phamtaiece/Capstone-Sightline/Weekly Reports/Week_20.docx

WEEKLY PROGRESS REPORT

Sightline Capstone Project

Week 20

27 May 2019

Tai:

This week:

- Work on the flight test with Kimball
- Work on the Poster with Kimball
- Work on the final report document

Next week:

- Meeting with Jeremy and do another fight test on Wednesday
- Finalize the poster design
- Work on the final report

Question:

None at this time

Kimball:

This Week:

- Attempted flight test with SLA1500OEM, had issues recording video to internal SD card
- There was a manufacturing delay of the SLA1500CAM due to a misaligned solder mask issue. The error was fixed new gerbers were compiled and sent to the manufacturer. With the holiday weekend we haven’t had any updates from the manufacturer.
- Finalized poster design with Tai pushed to Github (https://github.com/phamtaiece/Capstone-Sightline/blob/master/Final%20Documentation/Poster/Poster2.pdf)

Next Week:

- Flight Test scheduled for Wednesday to test quad-copter with SightLine hardware
- SLA1500CAM Testing if it arrives
- Upload poster design for printing
- Continue working on Design Report

Comments/Questions:

None at this time
