phamtaiece/Capstone-Sightline/Weekly Reports/Week_19.docx

WEEKLY PROGRESS REPORT

Sightline Capstone Project

Week 19

20 May 2019

Tai:

This week:

- Meeting with sponsor and advisor.
- Working on Poster and final report contents.
- Create a fight test video for demo.

Next week:

- Work on another flight test this week
- Work on poster and final report
- Do the test for the SLA-1500-CAM board if possible.

Question:

None at this time

Kimball:

This Week:

- Created and added the following content to the poster:
  - Premise section with three Infographics describing the project
  - Quadcopter description with two quadcopter images
  - Hardware description with images of top and bottom layers of SLA1500CAM

There is a pdf of the current poster on Github (https://github.com/phamtaiece/Capstone-Sightline/blob/master/Final%20Documentation/Poster/Poster1.pdf) Any feedback on the content that is currently there would be greatly appreciated

Next Week:

- Flight Test scheduled
- SLA1500CAM boards are expected to arrive on Friday
- SLA1500CAM Testing
- Finalize Poster content
- Send final poster content to graphic designer
- Continue working on Design Report

Comments/Questions:

None at this time
