phamtaiece/Capstone-Sightline/General Documents/1500CAMPROTOTYPE_FlightChecklist.docx

# CAPSTONE FLIGHT TEST

# GOAL:

Perform a flight test carrying the 1500-CAM prototype.

- Fly with additional weight
- Additional electrical load
- Use 1500-OEM to record flight video for post processing

# PREFLIGHT CHECKLIST

1. Verify Ethernet communication
2. Verify video in main Panel+ window
3. Verify streaming statistics
4. Verify microSD card is active

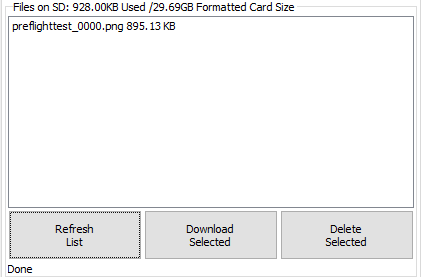
[picture p30: figure]

# FLIGHT PROCEDURE

1. Menu → Configure → KLV Setup…
  a. Simulate Data
  b. Display Decoded Value == MISB User Set
  c. VERIFY: UTC TIME == Current Date and Time
  d. Stop Simulation
  e. Tag Data Rate
    i. Check ID 2 box
    ii. Set Frame Step = 1
    iii. Send
  f. Close KLV Dialog
2. Verify KLV rate statistics
3. Record Tab: Single Frames (Snapshots)
  a. Set Filename (text only; no numbers)
  b. Start

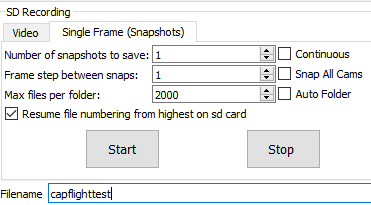
[picture p31: figure]

  c. Refresh List
  d. VERIFY: new file
4. Record Tab: Video
  a. Start
  b. Refresh List
  c. VERIFY: new file is getting created

# 1500-SETUP

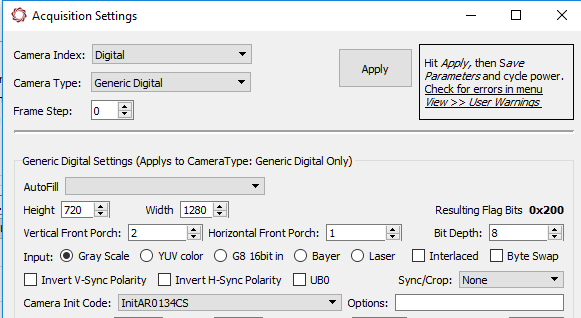
[picture p32: figure]
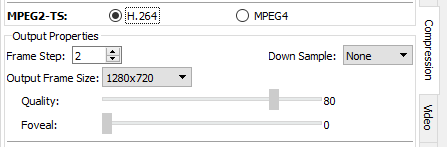
[picture p33: figure]
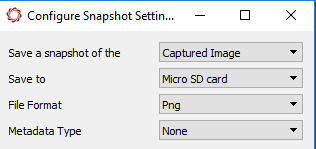
[picture p34: figure]
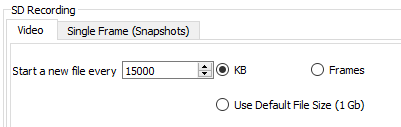
[picture p35: figure]
