phamtaiece/Capstone-Sightline/Final Documentation/PowerPoint/UAVLandingAid.pptx

UAV Visual Landing Aid

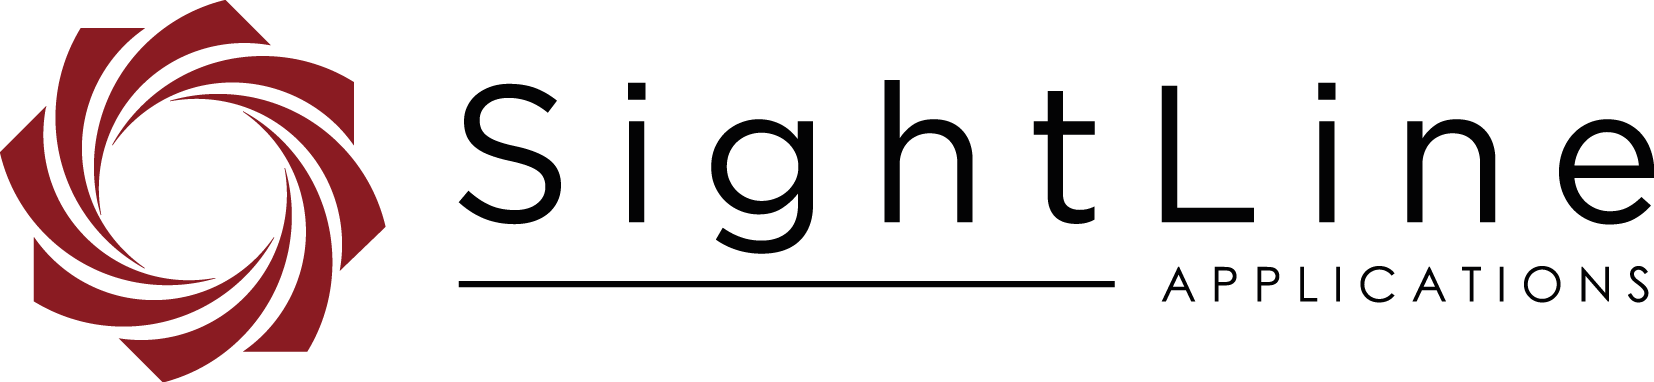
[picture p64: figure]

Tai Pham
Kimball Davis

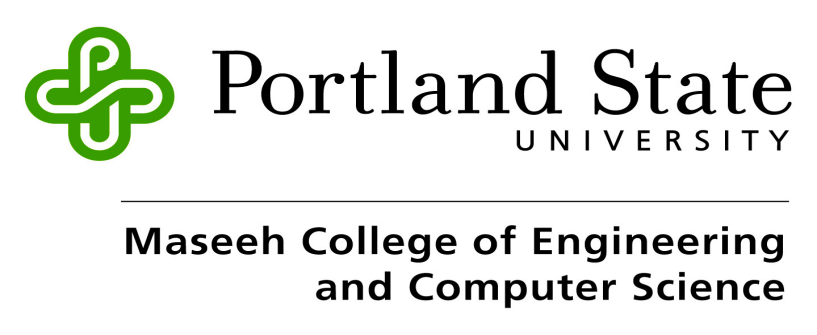
[picture p65: figure]

## Slide 2

SightLine Applications has developed a precision visual landing aid for UAV's. The Landing Aid supports autonomous landing operations by automatically finding and tracking an easy to place landing pattern.

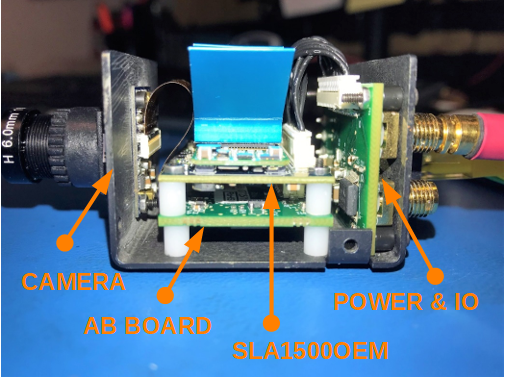
[picture p66: figure]
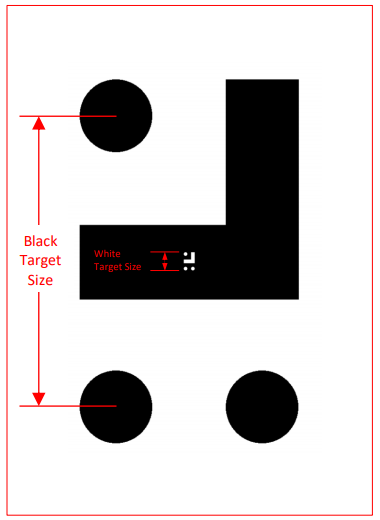
[picture p67: figure]

## Slide 3

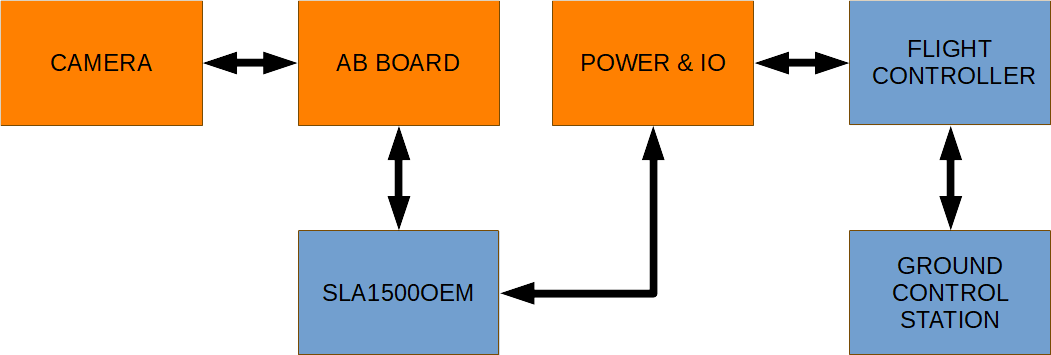
[picture p68: figure]

## Slide 4

## Slide 5

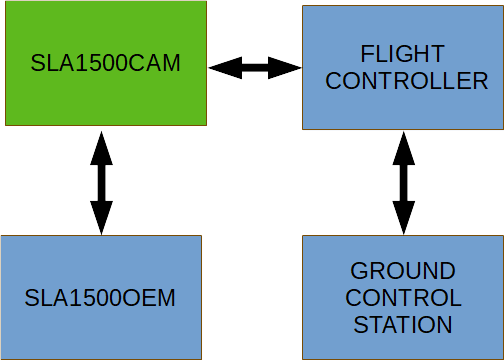
[picture p69: figure]
