phamtaiece/Capstone-Sightline/Final Documentation/Design Report/2019_ECECapstone_Team21.pdf

### PORTLAND STATE UNIVERSITY

DEPARTMENT OF ELECTRICAL AND COMPUTER ENGINEERING


## 2019 ECE CAPSTONE TEAM 21

FACULTY ADVISOR: ROY KRAVITZ, M.S.

SPONSOR: JEREMY SARAO, SIGHTLINE APPLICATIONS

# UAV Landing Aid - Design Report

### Authors:

KIMBALL S. DAVIS

TAI PHAM

June 5, 2019

### Abstract

Integration of the SightLine Landing Aid for end users is problematic. Often drone operators want to just “plug in” a component and fly their mission. Installing software components is acceptable, but any requirement for programming is a barrier to entry or a complete show stopper. Various cables, power, and other electrical connectivity issues are also difficult for vehicle integrator. Rugged or at least robust mechanical enclosures, easy mounting, and environmental reliability are equally important. Lastly, choice of optical system (camera) for the greatest range has cause adoption delays in that it has been a decision left to the integrator. Recognizing the needs from the end-users, SightLine wants to develop a plug and play precision landing aid for UAVs and expect that this new project will be highly valuable to a wide range of multi-copter integrator.
Our solution to the problem involves: I. Selecting, and building a consumer level quad-copter that will be easily customizable for testing II. Designing a camera that will connect directly to the SightLine hardware, distribute power, and facilitate communication III. Research and development of documentation and software to meet plug and play expectations.
The selection, build, and testing of a custom quad-copter is a complicated task with many variables. GPS signal degradation made indoor flight tests impossible, and safe outdoor testing locations were hard to find. We did successfully build, and autonomously fly the Pixhawk4 controlled quad-copter using QGroundControl mission planning software. In the meantime, a camera for the SightLine hardware was designed utilizing an AR0134CS optical sensor. The camera board was also designed to provide power distribution, and facilitate communication between the Pixhawk 4 flight controller and the Sight-Line hardware.
*Insert SLA1500CAM Test Results summary Here*
Based on our project, the QGroundControl has demonstrated a great ability to control our quad-copter autonomously. The QGroundControl provides the ability to fully control all quad-copter parameters and as well as setting up a mission. We have successfully flied the drone autonomously using QGroundControl includes takeoff, land, fly the mission, and return to land. The precision landing feature on QGround-Control is not very promising. For the simple function like takeoff and landing, the position between takeoff and land was about 1 meter. For the flying to a destination and return, the difference in position was 2 meter. Additionally, before doing the flight test, we also use Mission Planner to simulate the flight and learn how to control the quad-copter’s parameters.
*What are the limitations? The limitation comes from both QGroundControl and SightLine hardware. Since SightLine hardware, or 1500-SLA-kit, is unable to talk with QGroundControl and as well as, we don’t know if QGroundControl is capable of talking to SightLine hardware. There will be some works that SightLine need to be done with their hardware so it will be able to talk with QGroundControl. *What are the Future implications of the project?* The project is now divided into two parts. The first part is understand the Ground Control State software (QGroundControl) and hardware such as Pixhawk 4, and SLA1500CAM. The second part will emphasize in software and communication development. SightLine and our team has determined to leave the second part of the project for the future capstone team. With our achievements on this project, we have a strong belief that the future team will be successful in this project and future function development.

### Contents

1 Project Overview | 4
2 Results(Technical Detail) | 5
3 Conclusion/What’s Left to do | 11
4 Appendix | 12
5 References | 13

### List of Figures

1 | Level 1 block diagram of SLA1500CAM REV 8.0 | | 6
2 | Connector summary for SLA1500CAM REV 8.0 | | 7
3 | Connector summary for J1 | | 8
4 | SLA 1500 CAM REV 8.0 Schematic | | 9
5 | SLA1500CAM BOM REV 8.0 | | 10
6 | This is a caption for a blank figure | | 11
7 | This is a caption for a blank figure | | 11

### 1 Project Overview

### 1.1 Background

SightLine Applications has developed a precision visual landing algorithm that provides an excellent set of benefits:

- Works in degraded and denied GPS environments – Safety and reliability
- Reduces operator training and landing phase complexity.
- Provides detection functions for landing zone safety - detect people, animals, or objects from entering the landing zone
- Provides a rich set of telemetry for flight controllers. 30 Hz data with range, XY offsets, relative azimuth, etc.
- Supports landing on moving platforms - ground vehicles, marine.
- Is not impacted by bright sun or low light conditions.
- Can be used with Thermal (IR) cameras as well as visible (EO) cameras
- Effective range of operation (distance to target) only limited by the size of the landing pattern used

### 1.2 Problem Definition

Integration of the SightLine Landing Aid for end users is problematic for two main reasons:

1. Connectivity issues with a wide range of cameras.
2. Communication issues with a wide range of flight controller hardware and software.

Currently the end user selects a camera to be used with the SightLine processing hardware. A wide range of cameras must be supported, and custom AB boards must be designed for each one to interface with the SightLine hardware. Each of these AB boards can have cable, power, and electrical connectivity issues that are problematic for the end user. There is also a wide range of flight controller hardware and software, each with a myriad of different communication protocols. Installing software components to facilitate this communication is fine for the end user, but if any programming needs to be done this is usually a complete show stopper.

### 1.3 Solution

The proposed solution to these problems is to develop an all in one unit (SightLine Hardware w/Camera) with plug and play capabilities that can be directly connected to a consumer level flight controller. By doing so camera connectivity and selection problems are eliminated, and communication and software deployment are made much easier for the end user. We will build an off the shelf quad-copter with autonomous flight capabilities to test communication between current SightLine hardware, and our newly designed camera interface.

### 1.4 Project Management

The project is divided into three sections:

1. Choosing and building an "off the shelf" quad-copter that uses a Pixhawk 4 flight controller that can be used for testing
2. Designing a camera based on the On-Semi AR0134CS optical sensor that connects directly to the SightLine hardware, distributes power, and facilitates communication between the flight controller and SightLine hardware
3. Research and development of documentation and software installers to meet plug and play expectations using QGroundControl flight control and mission planning software

*Insert Project Roles and Responsibilities here*

### 1.4.1 Project Timeline

*Insert Project Timeline here*

### 2 Results(Technical Detail)

### 2.1 Quadcopter

Lorem ipsum dolor sit amet, consectetuer adipiscing elit. Etiam lobortis facilisis sem. Nullam nec mi et neque pharetra sollicitudin. Praesent imperdiet mi nec ante. Donec ullamcorper, felis non sodales commodo, lectus velit ultrices augue, a dignissim nibh lectus placerat pede. Vivamus nunc nunc, molestie ut, ultricies vel, semper in, velit. Ut porttitor. Praesent in sapien. Lorem ipsum dolor sit amet, consectetuer adipiscing elit. Duis fringilla tristique neque. Sed interdum libero ut metus. Pellentesque placerat. Nam rutrum augue a leo. Morbi sed elit sit amet ante lobortis sollicitudin. Praesent blandit blandit mauris. Praesent lectus tellus, aliquet aliquam, luctus a, egestas a, turpis. Mauris lacinia lorem sit amet ipsum. Nunc quis urna dictum turpis accumsan semper.

### 2.2 Hardware

The 1x1.5” SLA1500CAM utilizes the On-Semi AR0134CS, a monochrome 1/3-inch 1.2 Mp CMOS digital sensor with a 74MHz output. It connects seamlessly with the SightLine SLA1500OEM image processing hardware via a 50-pin Hirose DF12 connector. With a 5V input the SLA1500CAM converts and distributes the 3.3V, 2.8V, and 1.8V required for operation.

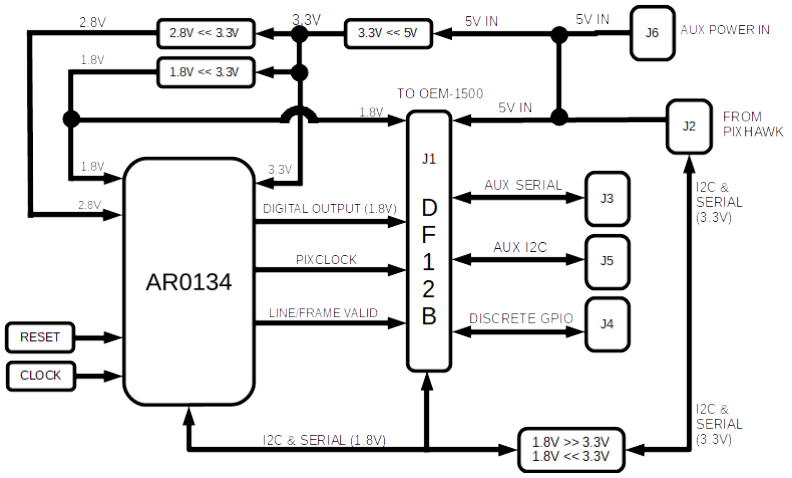
[picture p70: figure]

Figure 1: Level 1 block diagram of SLA1500CAM REV 8.0

The SLA1500CAM also provides bi-directional level translation for serial and I2C communication between the SightLine hardware, the flight controller, and the optical sensor. There are five I/O ports using standard Molex and JST connectors:

- Power and serial communication for the flight controller
- Auxiliary I2C bus
- Auxiliary serial communication
- Auxiliary power in

### 2.3 Connector Summary

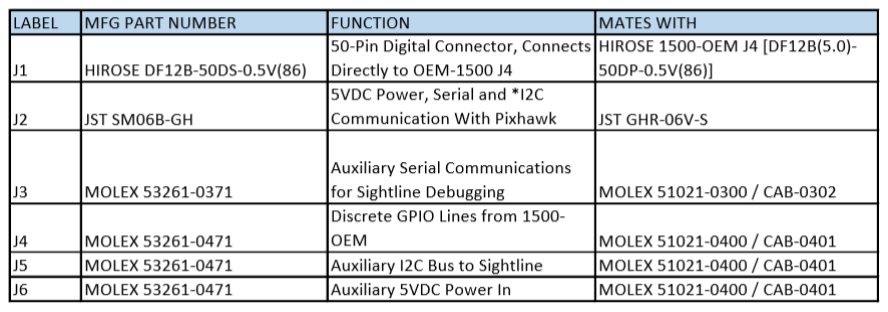
[picture p71: figure]

Figure 2: Connector summary for SLA1500CAM REV 8.0

### 2.3.1 Connector J1

Digital camera, serial, power for SLA1500OEM
This connector is designed to mate with the SLA1500OEM J4 connector.


Figure 3: Connector summary for J1

The GPIO connections for J1 are as follows:

- CAMGPIO 172 is connected to DNP Resistor R7 to AR0134 TRIGGER
- CAMGPIO 173 is connected to DNP Resistor R8 to AR0134 FLASH
- CAMGPIO 174 is connected to AR0134 RESET
- CAMGPIO 175 is connected to AR0134 STANDBY
- CAMGPIO 178 is connected to DNP resistor R26 to AR0134 OEBAR

AR0134 OEBAR is tied to ground with 0 OHM resistor R27.
*R27 MUST BE REMOVED BEFORE R26 IS INSTALLED AND CAMGPIO 178 CAN BE USED.


Figure 4: SLA 1500 CAM REV 8.0 Schematic

9

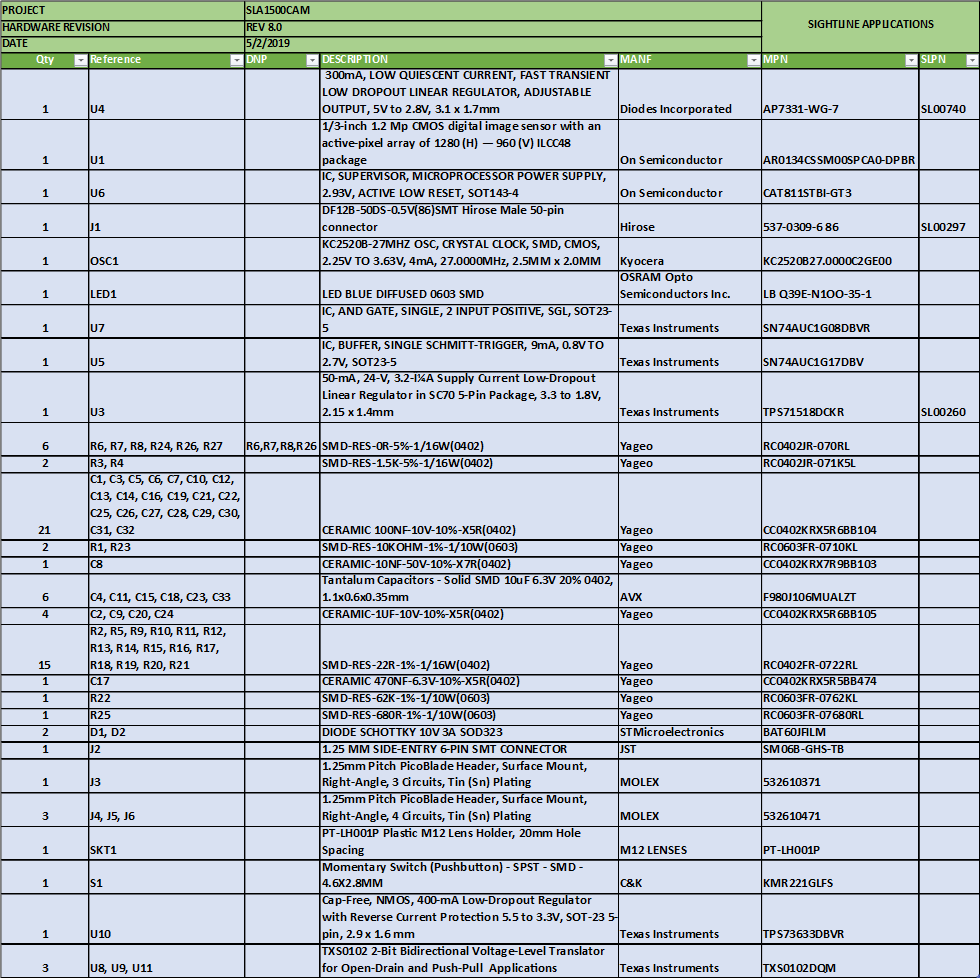
[picture p72: figure]

Figure 5: SLA1500CAM BOM REV 8.0

The schematic and PCB were designed using EAGLE CAD 9.2.1. Many of the component footprints and devices were unavailable and were designed specifically for the project. This involved designing the device, footprint, schematic symbol, and linking material data to each device. The entire EAGLE library for the SLA1500CAM can be found in the GitHub repository.
Eagle Library for SLA1500CAM (https://github.com/phamtaiece/Capstone-Sightline/tree/master/EAGLE%20files/Library)

### 2.4 Software

Lorem ipsum dolor sit amet, consectetuer adipiscing elit. Etiam lobortis facilisis sem. Nullam nec mi et neque pharetra sollicitudin. Praesent imperdiet mi nec ante. Donec ullamcorper, felis non sodales commodo, lectus velit ultrices augue, a dignissim nibh lectus placerat pede. Vivamus nunc nunc, molestie ut, ultricies vel, semper in, velit. Ut porttitor. Praesent in sapien. Lorem ipsum dolor sit amet, consectetuer adipiscing elit. Duis fringilla tristique neque. Sed interdum libero ut metus. Pellentesque placerat. Nam rutrum augue a leo. Morbi sed elit sit amet ante lobortis sollicitudin. Praesent blandit blandit mauris. Praesent lectus tellus, aliquet aliquam, luctus a, egestas a, turpis. Mauris lacinia lorem sit amet ipsum. Nunc quis urna dictum turpis accumsan semper.

Figure 6: This is a caption for a blank figure

### 3 Conclusion/What’s Left to do

Lorem ipsum dolor sit amet, consectetuer adipiscing elit. Etiam lobortis facilisis sem. Nullam nec mi et neque pharetra sollicitudin. Praesent imperdiet mi nec ante. Donec ullamcorper, felis non sodales commodo, lectus velit ultrices augue, a dignissim nibh lectus placerat pede. Vivamus nunc nunc, molestie ut, ultricies vel, semper in, velit. Ut porttitor. Praesent in sapien. Lorem ipsum dolor sit amet, consectetuer adipiscing elit. Duis fringilla tristique neque. Sed interdum libero ut metus. Pellentesque placerat. Nam rutrum augue a leo. Morbi sed elit sit amet ante lobortis sollicitudin. Praesent blandit blandit mauris. Praesent lectus tellus, aliquet aliquam, luctus a, egestas a, turpis. Mauris lacinia lorem sit amet ipsum. Nunc quis urna dictum turpis accumsan semper.

Figure 7: This is a caption for a blank figure

### 4 Appendix

### 4.1 I

### 4.2 II

### 4.3 II

### 4.4 IV

### 4.5 V

### 5 References

1. Mali, P. (1960). Magnetic Amplifiers. New York, NY: John F. Rider.
2. Figure 1. Simple saturable reactor. Reprinted from Magnetic Amplifiers(pg. 27), by Paul Mali, 1960, New York, NY, John F. Rider Publisher, Inc.
3. Figure 2. Full-wave self-saturating magnetic amplifier. Reprinted from Magnetic Amplifiers(pg. 35), by Paul Mali, 1960, New York, NY, John F. Rider Publisher, Inc.
