phamtaiece/Capstone-Sightline/Final Documentation/Design Report/CONN_J2-6.pdf

J2 | | | J3
PIN | DESCRIPTION | SIGNAL LEVEL | PIN | DESCRIPTION
1 | POWER IN | 5V | 1 | GND
2 | TXC | 3.3V | 2 | RXC
3 | RXC | 3.3V | 3 | TXC
4 NO CONNECT
5 NO CONNECT
6 GND
J4 | | | J5
PIN | DESCRIPTION | SIGNAL LEVEL | PIN | DESCRIPTION
1 | GND | | 1 | VSENSE
2 | CAMGPIO 172 | 1.8V | 2 | I2C SDA
3 | CAMGPIO 173 | 1.8V | 3 | I2C SCL
4 | CAMGPIO 178 | 1.8V | 4 | GND
J6
PIN | DESCRIPTION | SIGNAL LEVEL
1 | AUX POWER IN | 5V
2 | AUX POWER IN | 5V
3 GND
4 GND

SIGNAL LEVEL

3.3V
3.3V

SIGNAL LEVEL
3.3V
1.8V
1.8V
