phamtaiece/Capstone-Sightline/Final Documentation/Design Report/DF12B_J1_CONN.pdf

PIN | DESCRIPTION | SINGAL LEVEL | PIN | DESCRIPTION | SIGNAL LEVEL
1 | UART RX CAM | VIOSEL | 2 | UART TX CAM | VIOSEL
3 | LINE VALID | VIOSEL | 4 | FRAME VALID | VIOSEL
5 | DGND | | 6 | DGND
7 | 12C SDA | VIOSEL | 8 | I2C SCL | VIOSEL
9 | CAMGPIO 175 | VIOSEL | 10 | NO CONNECT
11 | NO CONNECT | | 12 | NO CONNECT
13 | CAMGPIO 174 | VIOSEL | 14 | CAMGPIO 173 | VIOSEL
15 | RXC | VIOSEL | 16 | TXC | VIOSEL
17 | DGND | | 18 | NO CONNECT
19 | CAMGPIO 178 | VIOSEL | 20 | NO CONNECT
21 | NO CONNECT | | 22 | NO CONNECT
23 | CAM D11 | VIOSEL | 24 | CAM D10 | VIOSEL
25 | CAM D9 | VIOSEL | 26 | CAM D8 | VIOSEL
27 | DGND | | 28 | DGND
29 | CAM D7 | VIOSEL | 30 | CAM D6 | VIOSEL
31 | CAM D5 | VIOSEL | 32 | CAM D4 | VIOSEL
33 | CAM D3 | VIOSEL | 34 | CAM D2 | VIOSEL
35 | CAM D1 | VIOSEL | 36 | CAM D0 | VIOSEL
37 | DGND | | 38 | DGND
39 | CAM PCLK | VIOSEL | 40 | CAMGPIO 172 | VIOSEL
41 | DGND | | 42 | AGND
43 | NO CONNECT | | 44 | AGND
45 | DGND | | 46 | VIOSEL | 1.8V
47 | DGND | | 48 | POWER IN | 5V
49 | DGND | | 50 | POWER IN | 5V
