phamtaiece/Capstone-Sightline/Final Documentation/Poster/2019ECECapstoneTeam21.pdf

# UAV Visual Landing Aid

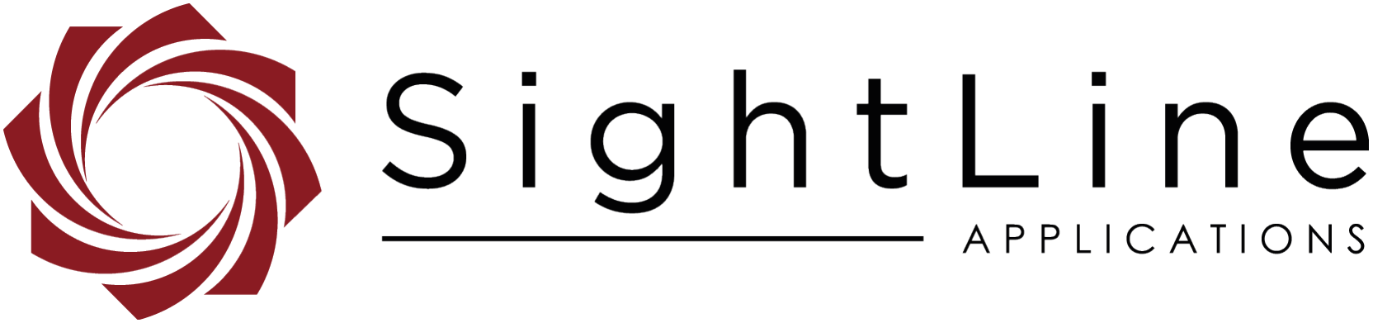
[picture p73: figure]

# Premise

SightLine Applications has developed a precision visual landing aid for UAV's. The Landing Aid supports autonomous landing operations by automatically finding and tracking an easy to place landing pattern.

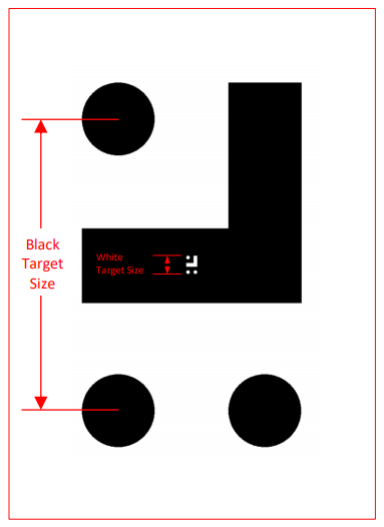
[picture p74: figure]
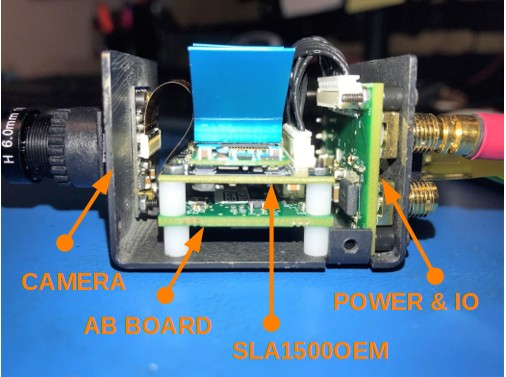
[picture p75: figure]
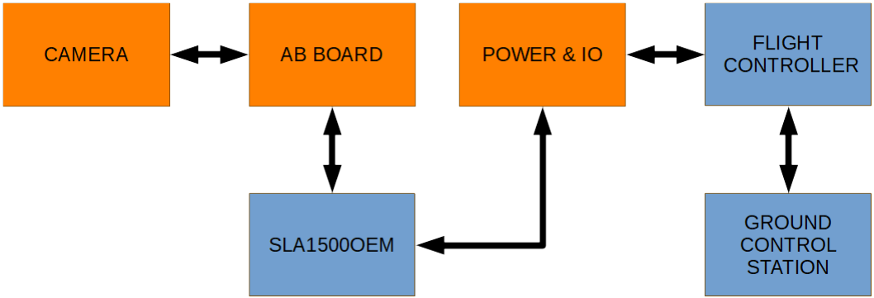
[picture p76: figure]

The multiple boards, complex wiring, and connections are problematic for the end user.

The proposed solution is to develop an all in one unit with plug and play capabilities that can be directly connected to the SightLine hardware.

By doing so camera connectivity and selection problems are eliminated, and deployment is made much easier for the end user.

# Solution

Mission Planner is an open source software that allows users and developers to fully control their drone. In this project, Mission Planner was used for setting up flight simulations.

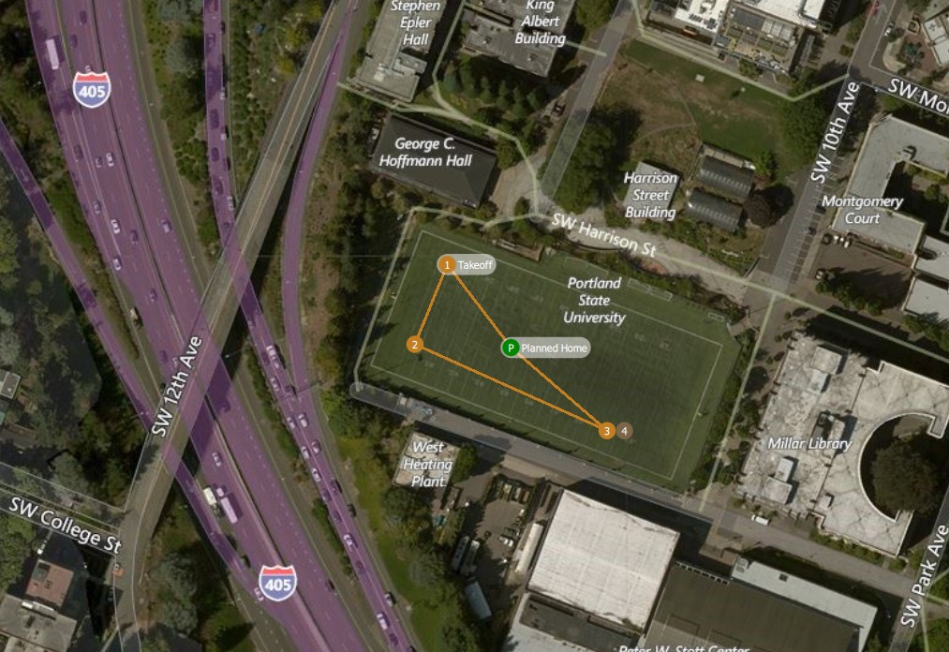
[picture p77: figure]
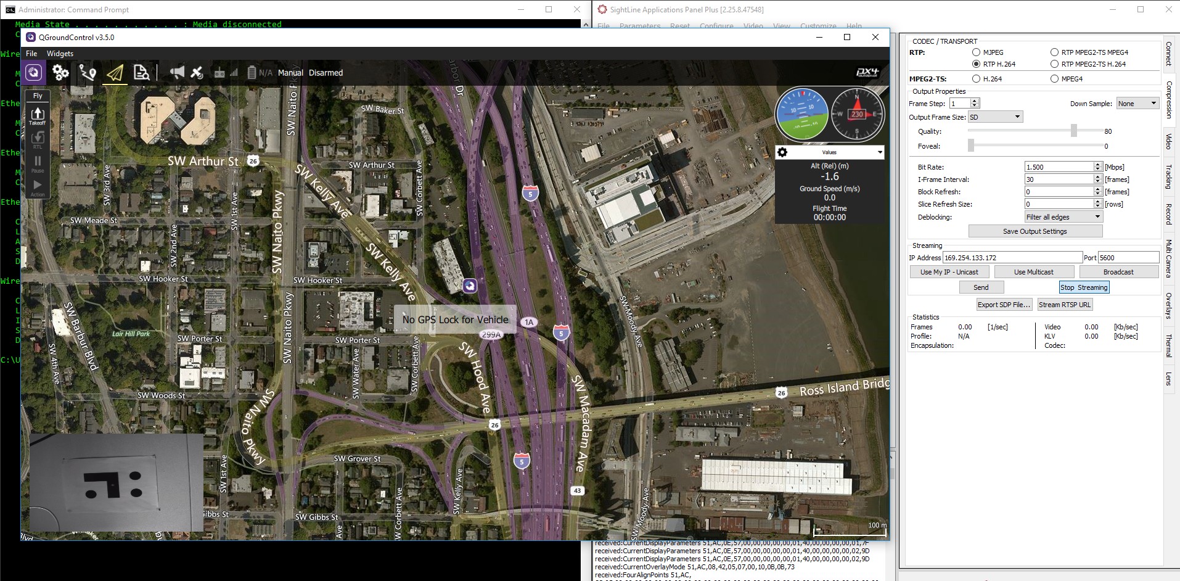
[picture p78: figure]

QGroundControl is an open-source software that allows users and developers to control their drone fully and autonomously. QGroundControl was used as the ground control station to send commands to the Pixhawk4 and control the quad-copter.

For testing purposes a custom quad-copter was built with a Pixhawk4 flight controller.

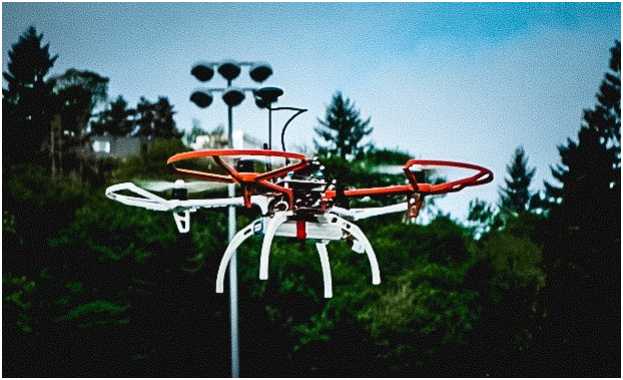
[picture p79: figure]
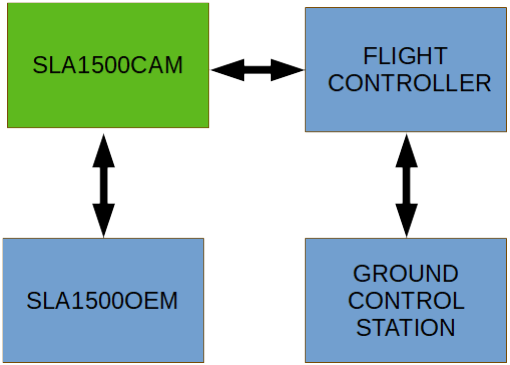
[picture p80: figure]
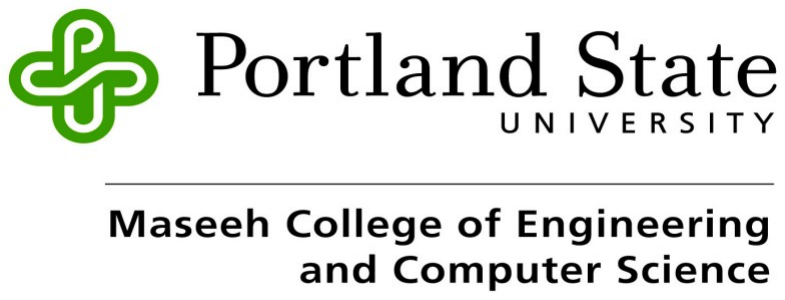
[picture p81: figure]

Using QGroundControl software the quad-copter was flown to different way points and landed autonomously via the ground control station. This was vital to understanding UAV operation, and end user experience.

## Software

## Hardware

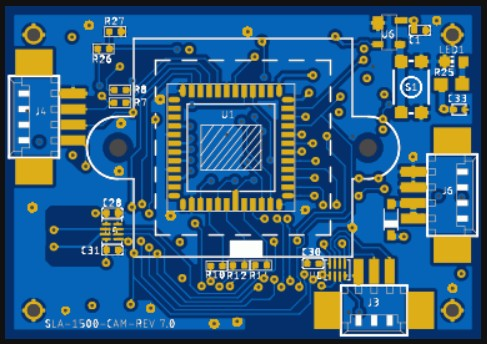
[picture p82: figure]
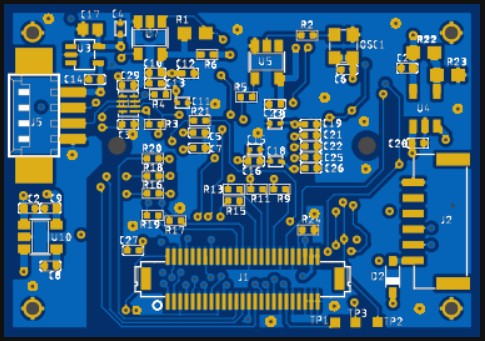
[picture p83: figure]

The 1”x1.5” SLA1500CAM utilizes the On-Semi AR0134CS a monochrome 1/3-inch 1.2 Mp CMOS digital sensor with a 74MHz output

- Connects seamlessly with the SightLine SLA1500OEM image processing hardware reducing cables and improving connectivity
- With 5V input converts and distributes the 3.3V, 2.8V, and 1.8V required for operation
- Provides level translation for communication between the SightLine hardware, the flight controller, and the optical sensor
- Offers additional power and communication I/O

# Results

- Successfully developed the SLA1500CAM
- Gained insight into communication between QGroundControl, Pixhawk4, and SightLine hardware
- Successfully completed autonomous flight and landing with custom quad-copter and QGroundControl

# Future Developments

- Compatibility issues remain with QGroundControl, SightLine hardware, and Pixhawk4
- Potentially, a new project will focus on software and communication for a future team that is interested in drone communication protocols
- With our achievements on this project we believe that full integration of the SLA1500CAM with plug and play capabilities can be achieved

This helped to understand the drone’s behavior and how adjusting the drone’s parameters could affect the behavior of the drone.
