phamtaiece/Capstone-Sightline/Quad_Copter/Capstone_Quadcopter_BOMPP.pdf

Project | Capstone Quadcopter | Sightline
Hardware Revision | V
Date | 01/31/19
Quantity | Description | Mfg | Weight (g) | Cost Per Item | Total Cost
1 | DJI FLAMEWHEEL F450 ARF KIT | DJI | 604.4 | $229.00 | $229.00
1 | DJI FLAMEWHEEL LANDING GEAR (4 pcs) | DJI | 60 | $17.50 | $17.50
1 | FrSky Taranis X9D Plus 16-Channel 2.4ghz ACCST Radio Transmitter | FrSky | N/A | $229.00 | $229.00
1 | FrSky X4RSB 3/16CH Telemetry Receiver Full Range | FrSky | 5.8 | $31.99 | $31.99
2 | Gens ace 14.8V 5000mAh 45C 4S LiPo Battery Pack | Gens Ace | 480 | $64.99 | $129.98
1 | PIXHAWK 4 ADVANCED DEVELOPMENT KIT | HOLYBRO | 200 | $210.95 | $210.95
1 | Discharger 1S-6S Digital Battery Pack Charger | Tenergy | N/A | $54.99 | $54.99
1 | PIXHAWK 4 RADIO TELEMETRY KIT | HOLYBRO | 15 | $39.95 | $39.95
1 | XT-60 CONNECTORS MALE/FEMALE | MakerDoIt | 12 | $11.99 | $11.99
1 | Prop Guards for DJI Flamewheel | Summit Link | 120 | $19.95 | $19.95
1 | RAYCorp 9450 Self-Tightening (9.4x5) Propellers. 8 Pieces(4CW, | RAYCORP | N/A | $13.99 | $13.99
| | ESTIMATED WEIGHT (g) | 1497.2 | Total Cost | $989.29
