phamtaiece/Capstone-Sightline/EAGLE files/Images/SLA1500_CAM_V7.pdf

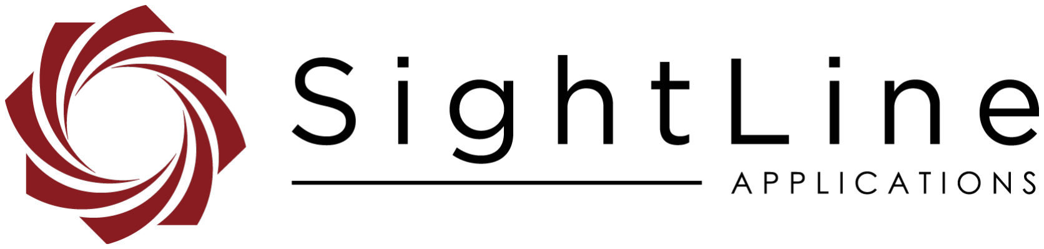
[picture p84: figure]

# SLA 1500 CAM REV 7.0

April 21, 2019

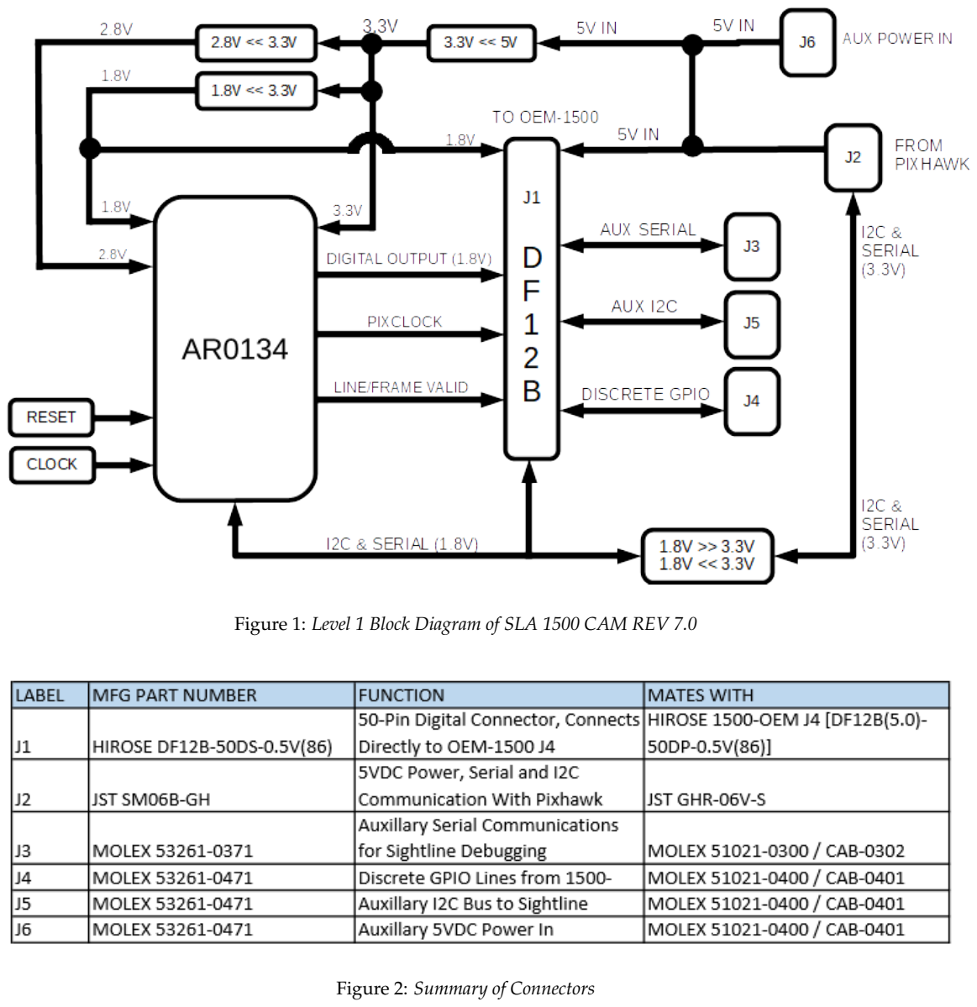
[picture p85: page 2]

Figure 1: Level 1 Block Diagram of SLA 1500 CAM REV 7.0

Figure 2: Summary of Connectors

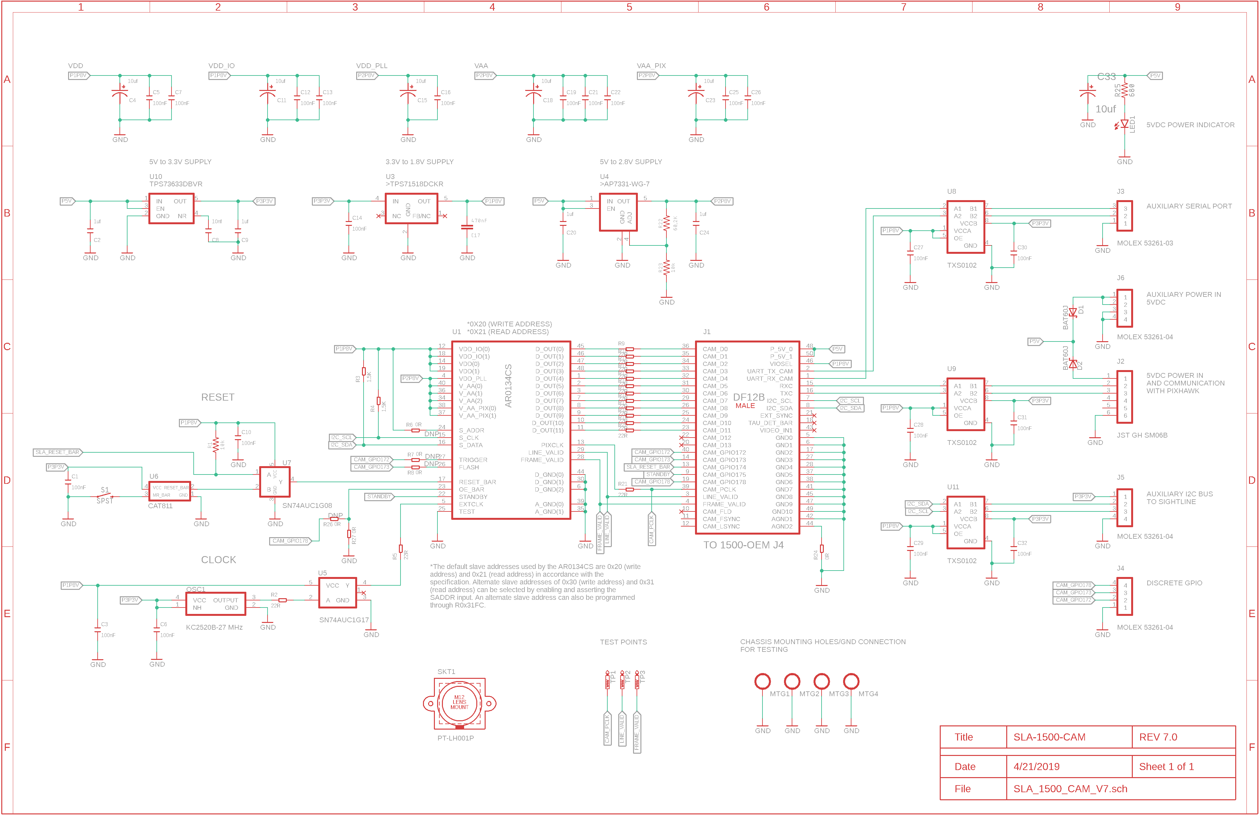
[picture p86: page 3]

Figure 3: SLA 1500 CAM REV 7.0 Schematic
