phamtaiece/Capstone-Sightline/EAGLE files/Images/SLA1500_CAM_V6.pdf

# SLA 1500 CAM REV 6.0

April 9, 2019

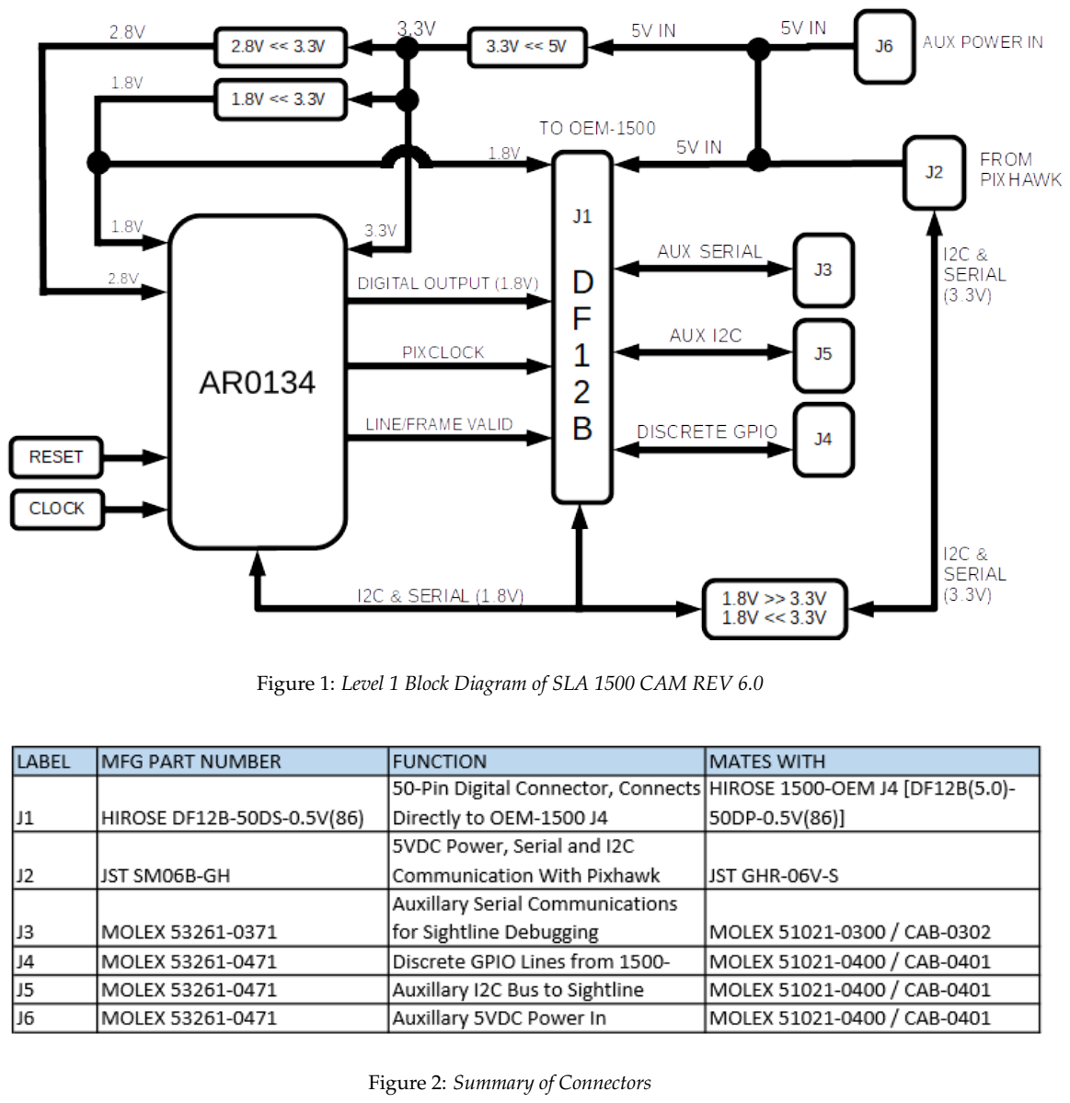
[picture p87: page 2]

Figure 1: Level 1 Block Diagram of SLA 1500 CAM REV 6.0

Figure 2: Summary of Connectors

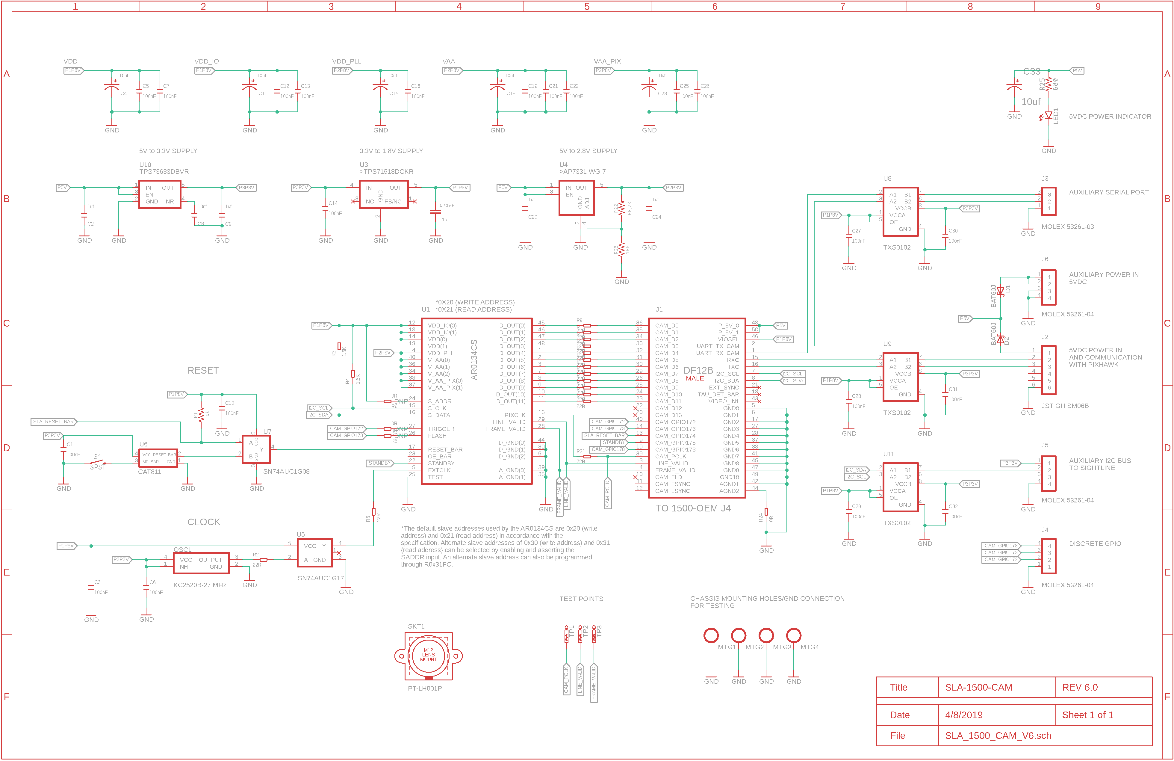
[picture p88: page 3]

Figure 3: SLA 1500 CAM REV 6.0 Schematic
