phamtaiece/Capstone-Sightline/EAGLE files/Images/SLA1500_CAM_V5.pdf

# SLA 1500 CAM REV 5.0

April 3, 2019

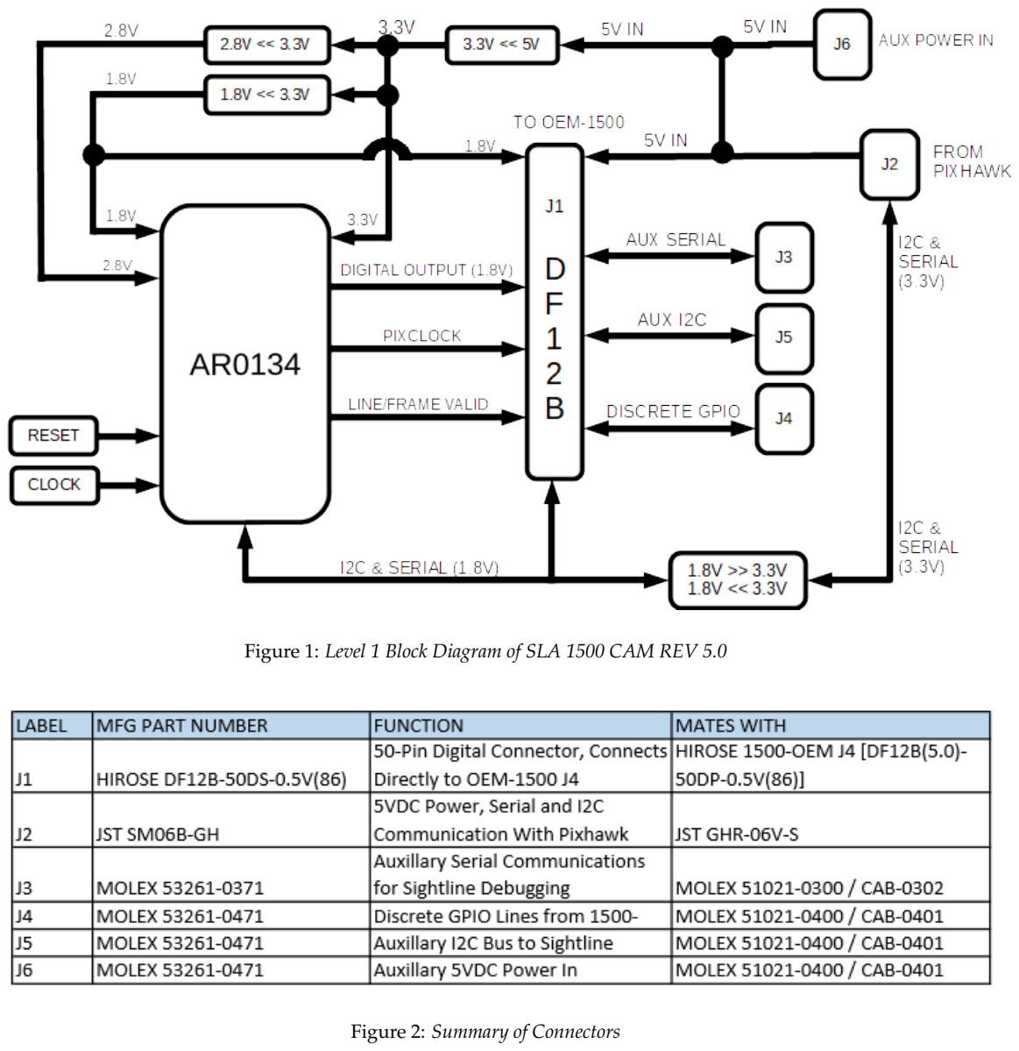
[picture p89: page 2]

Figure 1: Level 1 Block Diagram of SLA 1500 CAM REV 5.0

Figure 2: Summary of Connectors

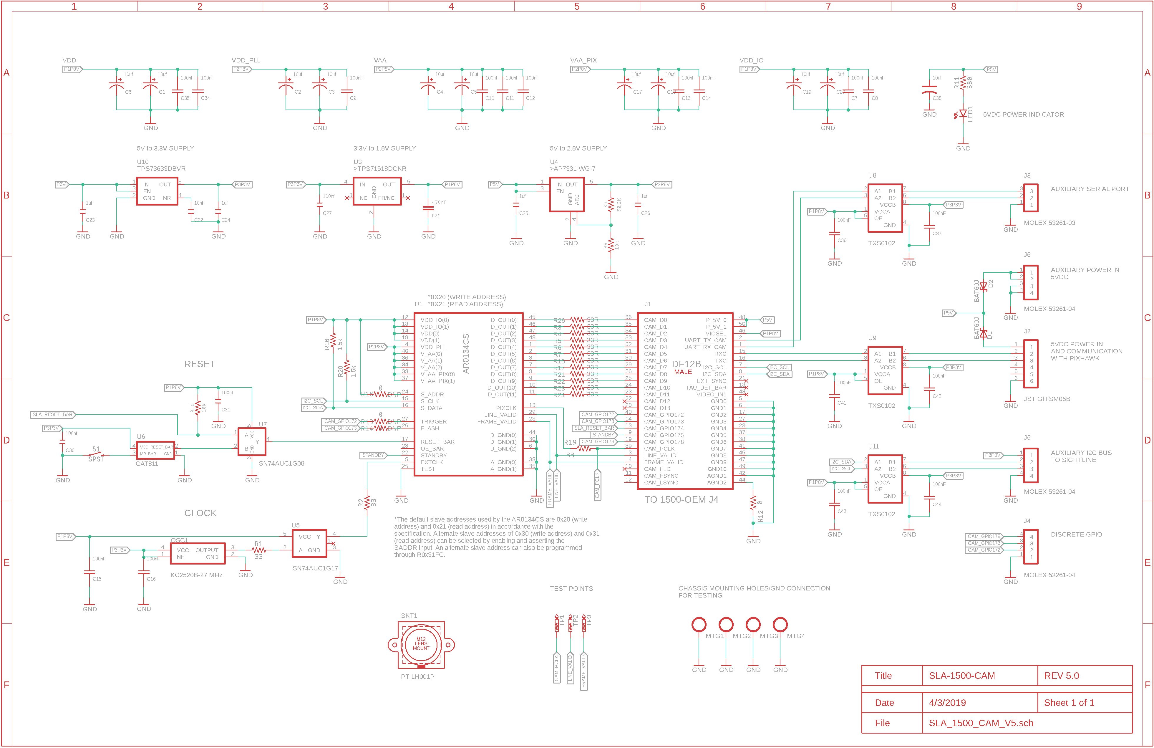
[picture p90: page 3]

Figure 3: SLA 1500 CAM REV 5.0 Schematic
