phamtaiece/Capstone-Sightline/EAGLE files/Images/SLA1500_CAM_V4.pdf

# SLA 1500 CAM REV 4.0

March 25, 2019

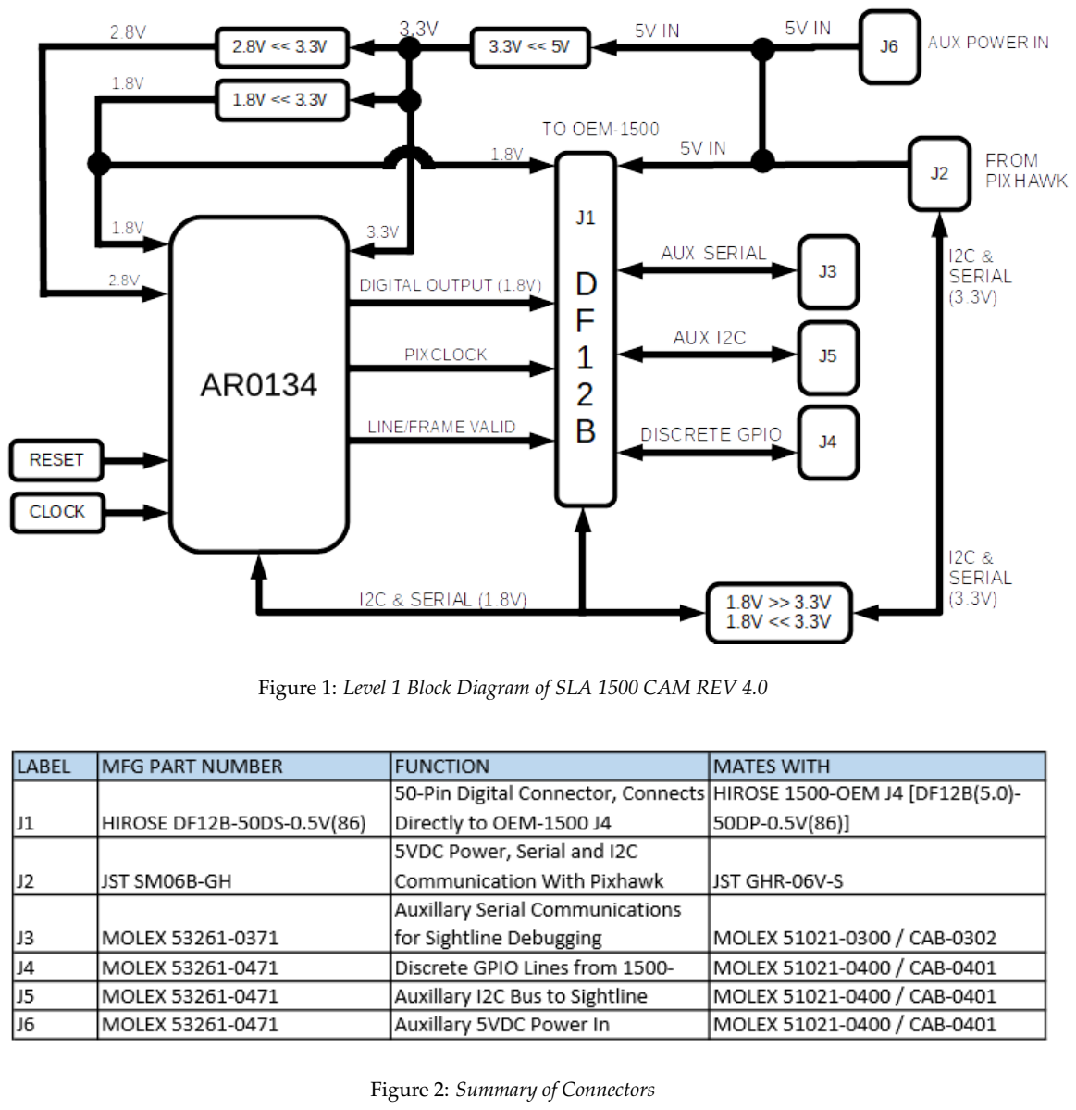
[picture p91: page 2]

Figure 1: Level 1 Block Diagram of SLA 1500 CAM REV 4.0

Figure 2: Summary of Connectors

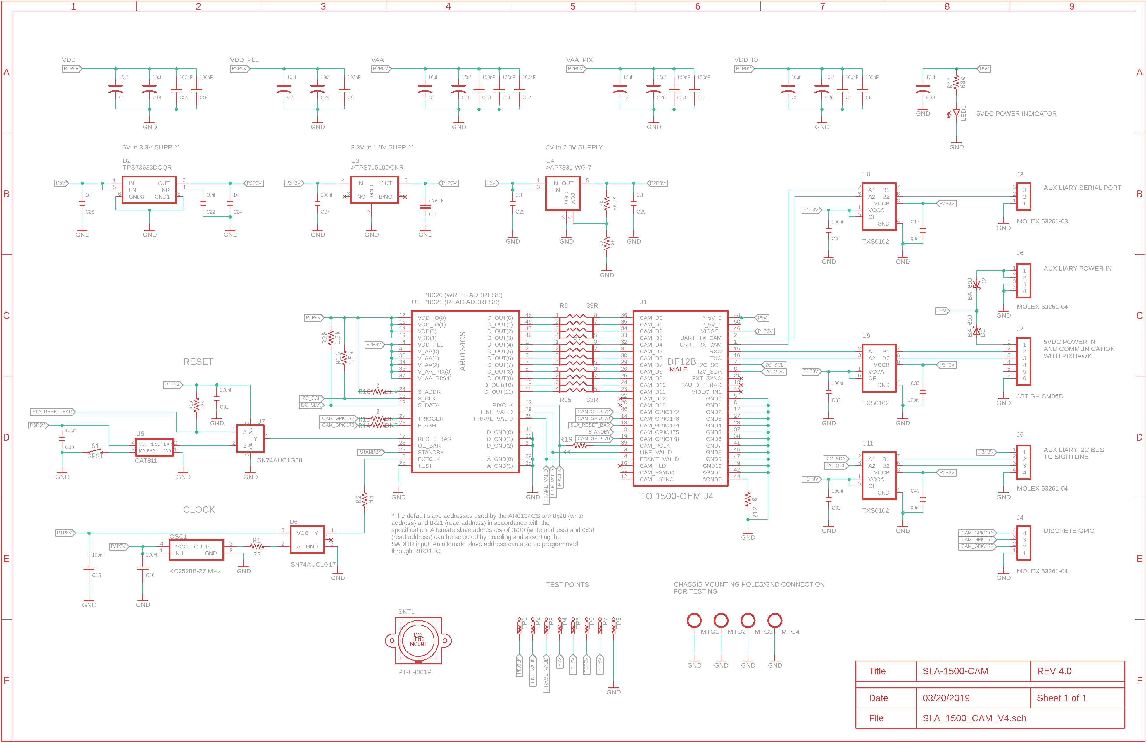
[picture p92: page 3]

Figure 3: SLA 1500 CAM REV 4.0 Schematic
