phamtaiece/Capstone-Sightline/EAGLE files/Images/SLA1500_CAM_V3.pdf

# SLA 1500 CAM REV 3.0

March 16, 2019

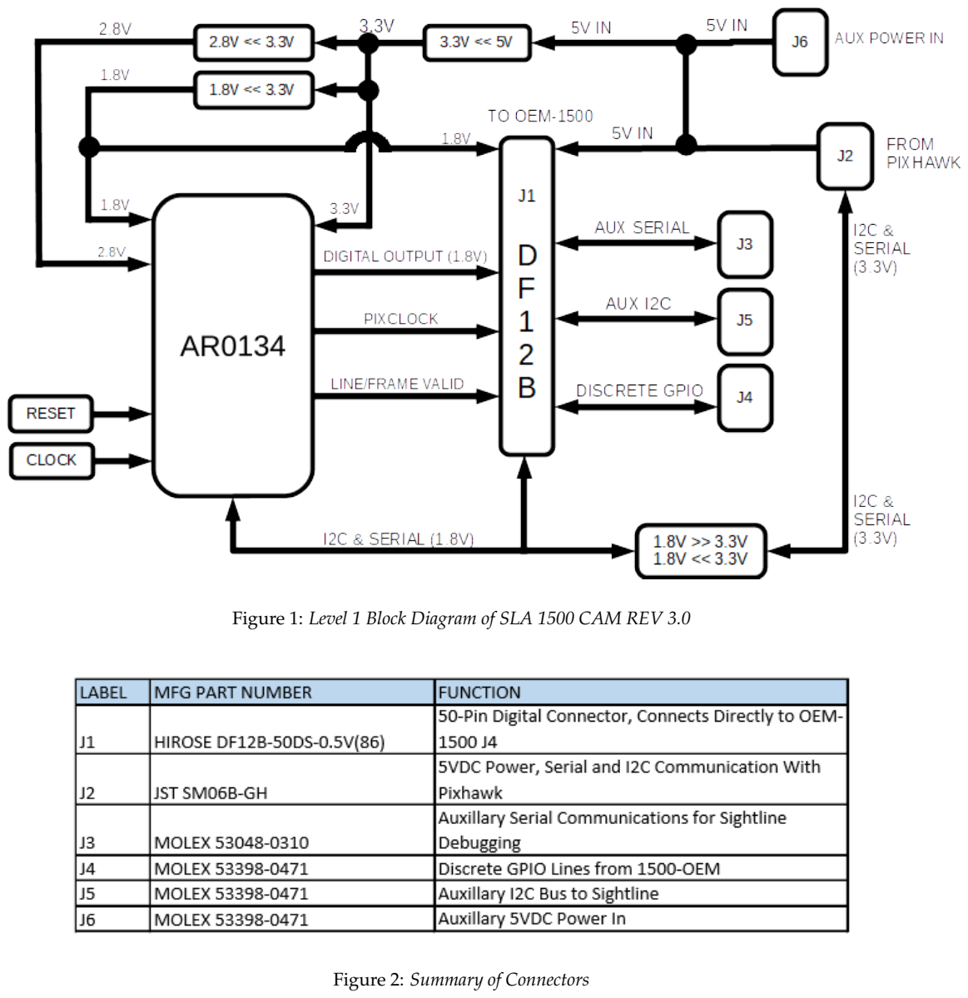
[picture p93: page 2]

Figure 1: Level 1 Block Diagram of SLA 1500 CAM REV 3.0

Figure 2: Summary of Connectors

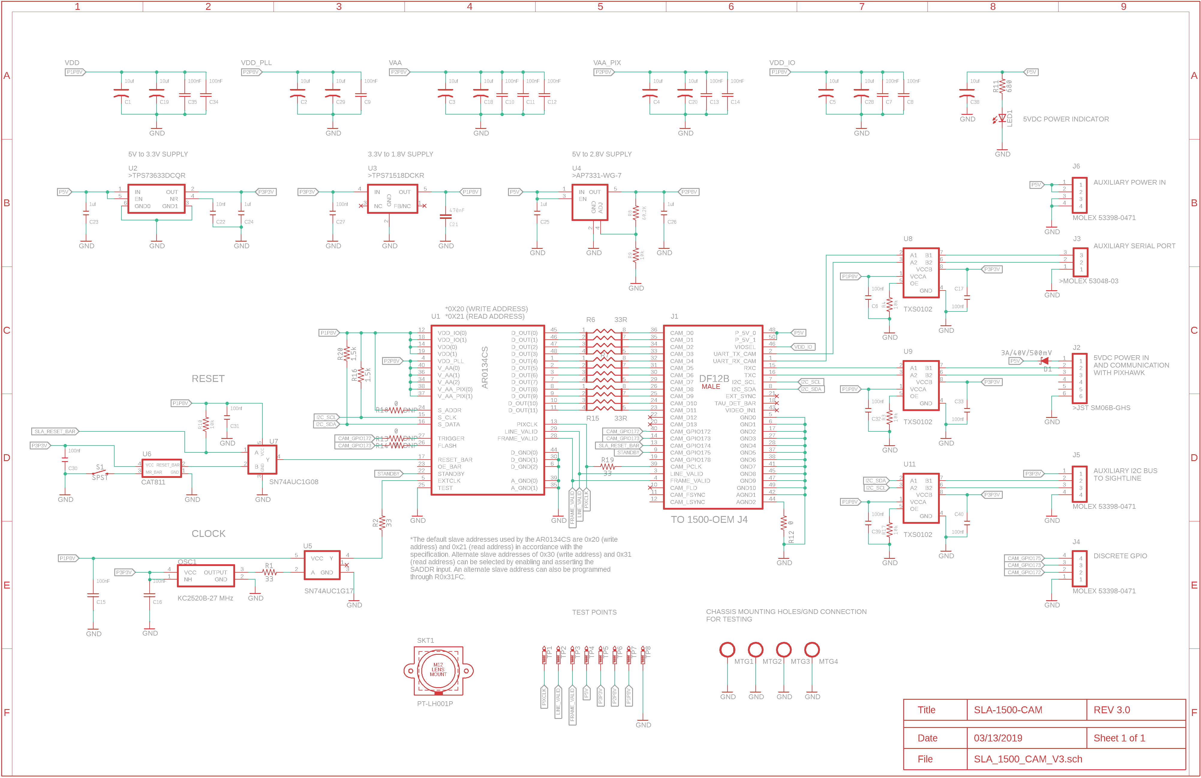
[picture p94: page 3]

Figure 3: SLA 1500 CAM REV 3.0 Schematic
