phamtaiece/Capstone-Sightline/EAGLE files/Images/SLA1500_CAM_V2.pdf

# SLA 1500 CAM REV 2.0

March 4, 2019

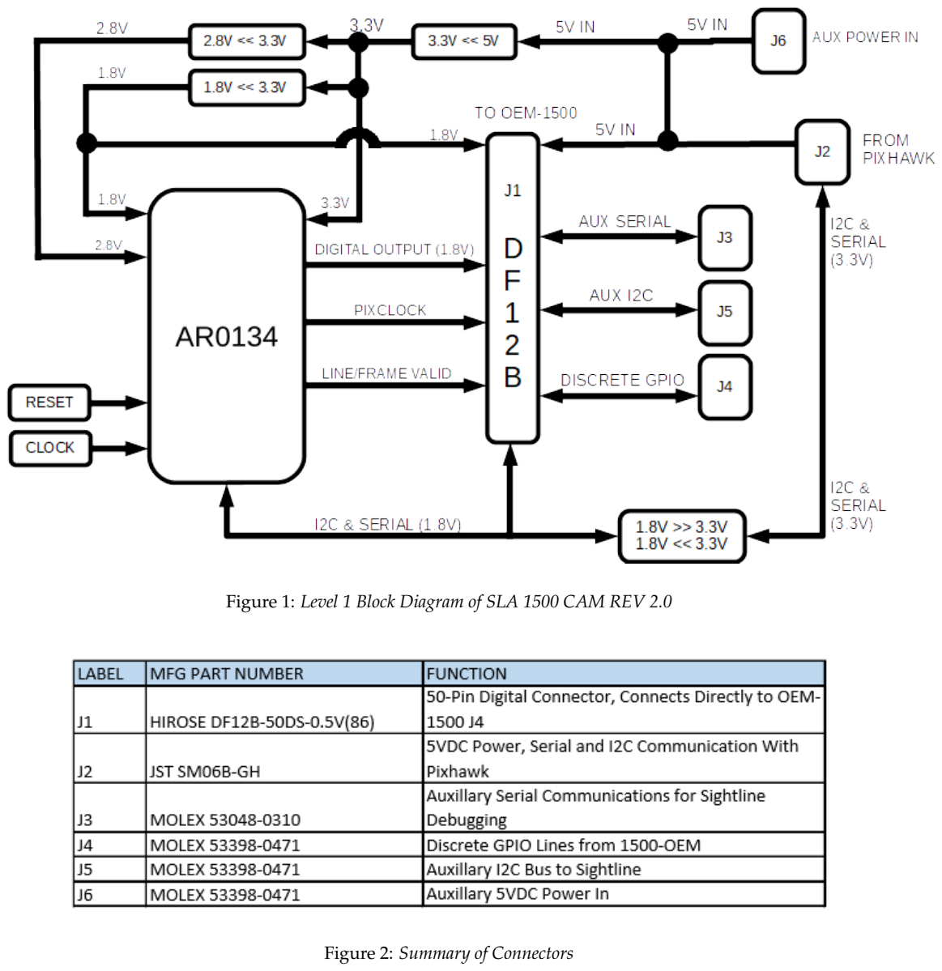
[picture p95: page 2]

Figure 1: Level 1 Block Diagram of SLA 1500 CAM REV 2.0

Figure 2: Summary of Connectors

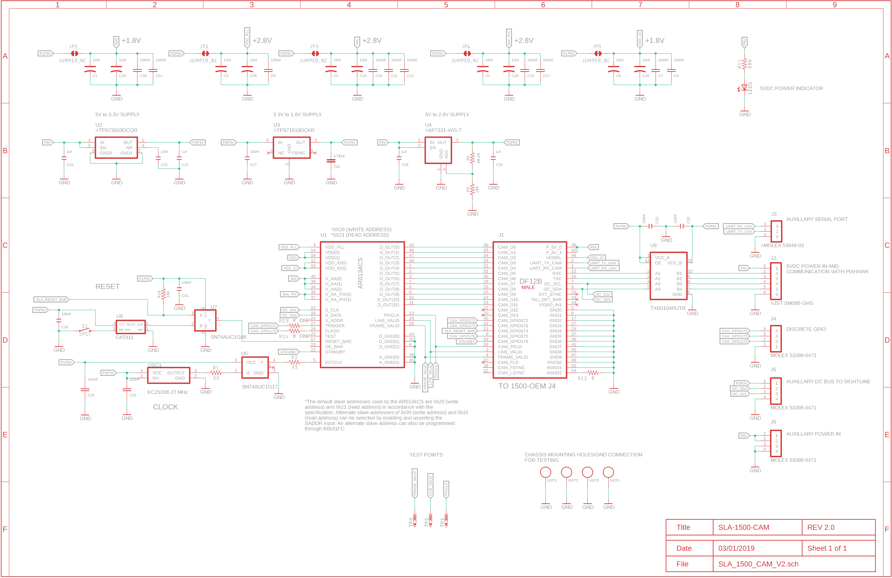
[picture p96: page 3]

Figure 3: SLA 1500 CAM REV 2.0 Schematic
