phamtaiece/Capstone-Sightline/EAGLE files/Images/SLA1500_CAM_V1.pdf

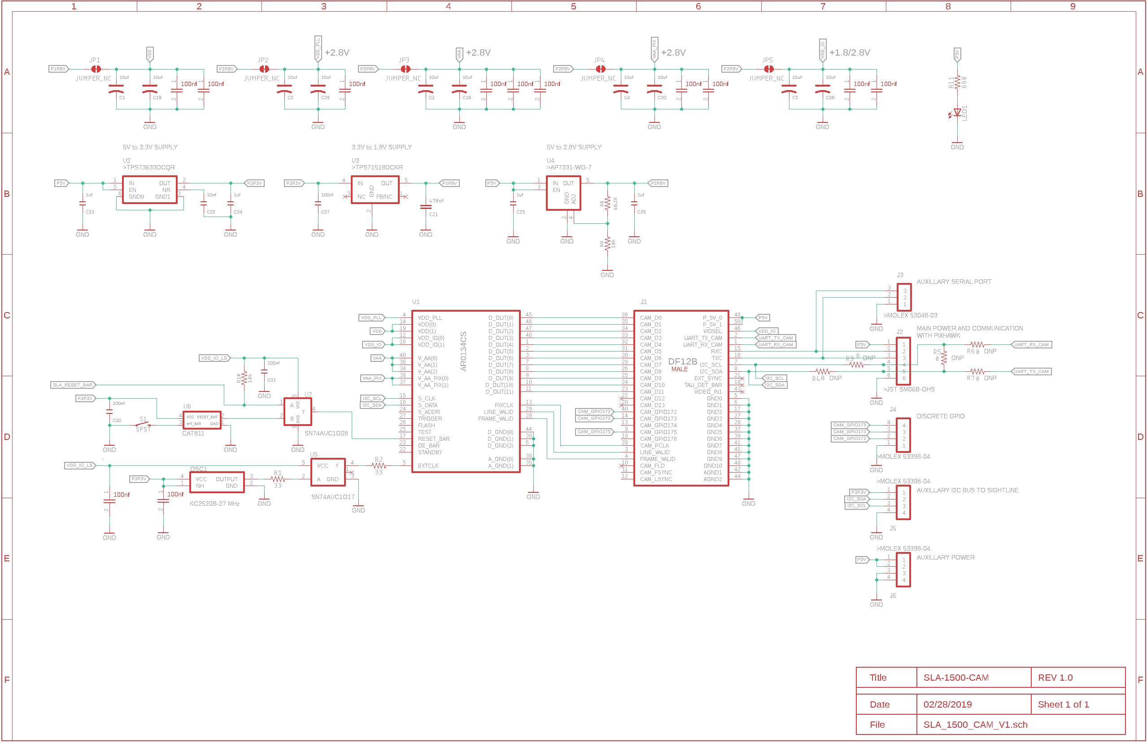
[picture p97: page 1]
