phamtaiece/Capstone-Sightline/Final Documentation/Design Report/quadcopter1.PNG

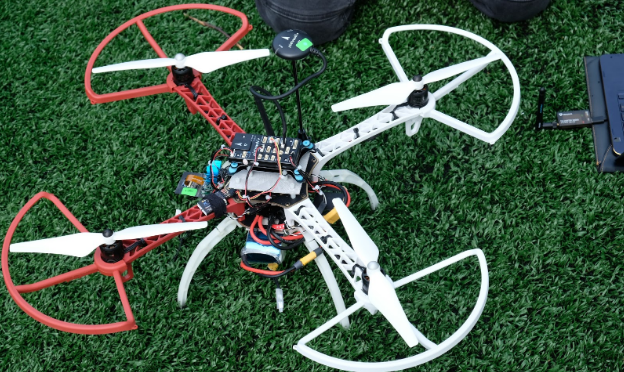
Final Documentation/Design Report/quadcopter1.PNG
