phamtaiece/Capstone-Sightline/Final Documentation/Design Report/QUADCOPTER2.png

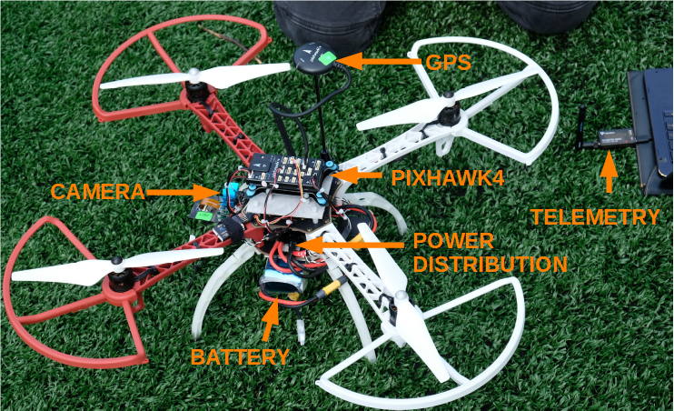
Final Documentation/Design Report/QUADCOPTER2.png
