phamtaiece/Capstone-Sightline/Final Documentation/JST.png

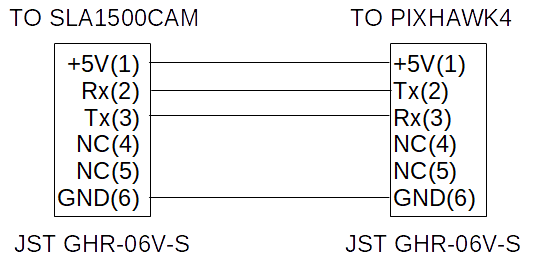
Final Documentation/JST.png
