phamtaiece/Capstone-Sightline/Final Documentation/Poster/quad1.jpg

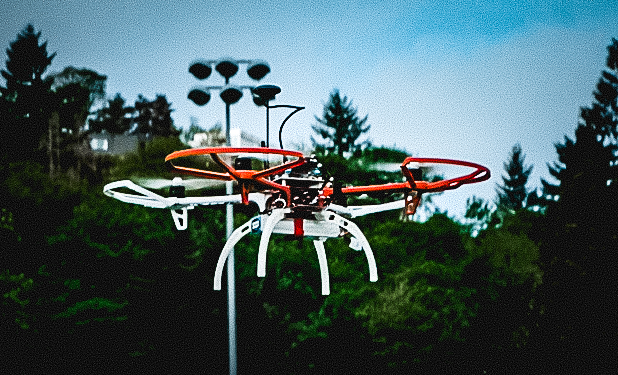
Final Documentation/Poster/quad1.jpg
