phamtaiece/Capstone-Sightline/Photos/20190213_102907.jpg

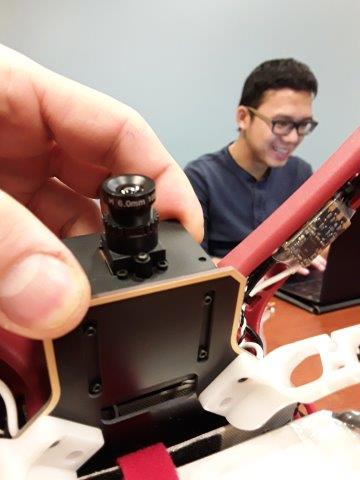
Photos/20190213_102907.jpg
