phamtaiece/Capstone-Sightline/Photos/20190213_102953.jpg

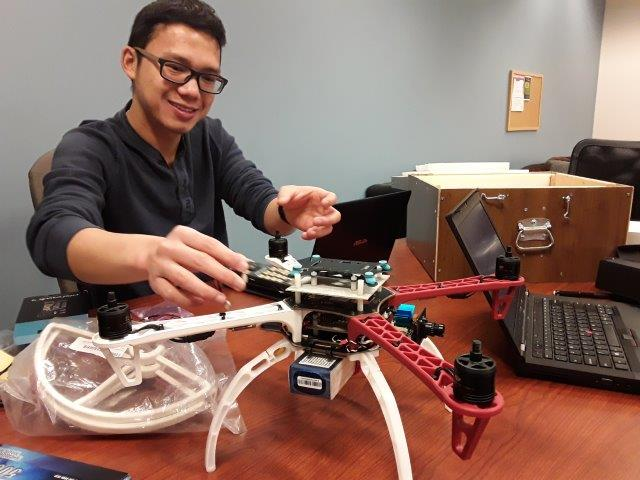
Photos/20190213_102953.jpg
