phamtaiece/Capstone-Sightline/Photos/20190213_113135.jpg

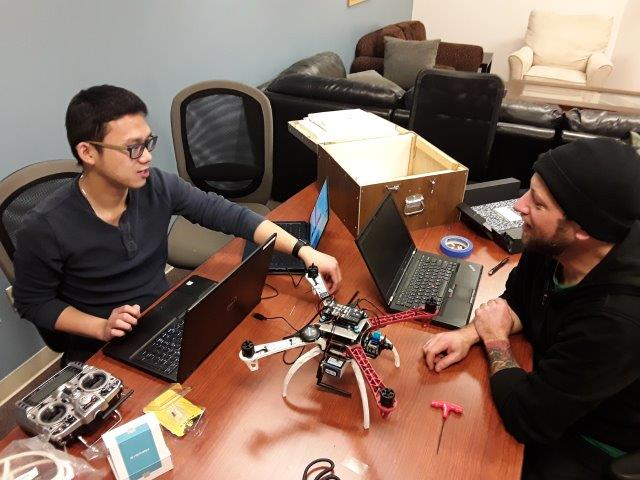
Photos/20190213_113135.jpg
