phamtaiece/Capstone-Sightline/Photos/20190214_130147.jpg

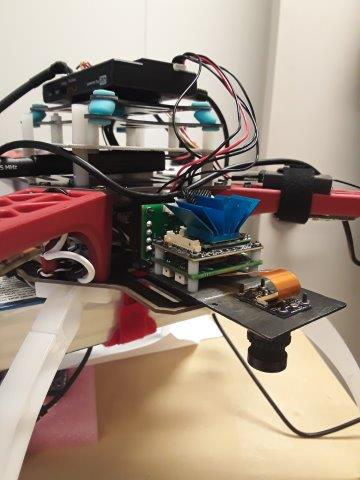
Photos/20190214_130147.jpg
