phamtaiece/Capstone-Sightline/Quad_Copter/DJI 450 datasheets/f450bottom_dim.png

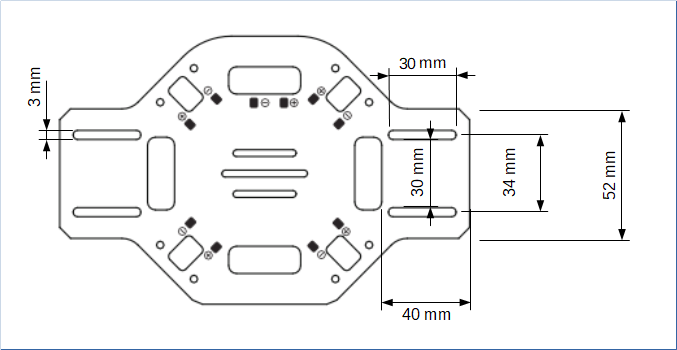
Quad_Copter/DJI 450 datasheets/f450bottom_dim.png
