phamtaiece/Capstone-Sightline/EAGLE files/SLA_1500_CAM_BOM_V8.xlsx

PROJECT |  | SLA1500CAM |  |  | SIGHTLINE APPLICATIONS
HARDWARE REVISION |  | REV 8.0
DATE |  | 2019-05-02
Qty | Reference | DNP | DESCRIPTION | MANF | MPN | SLPN
1 | U4 |  | 300mA, LOW QUIESCENT CURRENT, FAST TRANSIENT LOW DROPOUT LINEAR REGULATOR, ADJUSTABLE OUTPUT, 5V to 2.8V, 3.1 x 1.7mm | Diodes Incorporated | AP7331-WG-7 | SL00740
1 | U1 |  | 1/3-inch 1.2 Mp CMOS digital image sensor with an active-pixel array of 1280 (H) — 960 (V) ILCC48 package | On Semiconductor | AR0134CSSM00SPCA0-DPBR
1 | U6 |  | IC, SUPERVISOR, MICROPROCESSOR POWER SUPPLY, 2.93V, ACTIVE LOW RESET, SOT143-4 | On Semiconductor | CAT811STBI-GT3
1 | J1 |  | DF12B-50DS-0.5V(86)SMT Hirose Male 50-pin connector | Hirose | 537-0309-6 86 | SL00297
1 | OSC1 |  | KC2520B-27MHZ OSC, CRYSTAL CLOCK, SMD, CMOS, 2.25V TO 3.63V, 4mA, 27.0000MHz, 2.5MM x 2.0MM | Kyocera | KC2520B27.0000C2GE00
1 | LED1 |  | LED BLUE DIFFUSED 0603 SMD | OSRAM Opto Semiconductors Inc. | LB Q39E-N1OO-35-1
1 | U7 |  | IC, AND GATE, SINGLE, 2 INPUT POSITIVE, SGL, SOT23-5 | Texas Instruments | SN74AUC1G08DBVR
1 | U5 |  | IC, BUFFER, SINGLE SCHMITT-TRIGGER, 9mA, 0.8V TO 2.7V, SOT23-5 | Texas Instruments | SN74AUC1G17DBV
1 | U3 |  | 50-mA, 24-V, 3.2-Î¼A Supply Current Low-Dropout Linear Regulator in SC70 5-Pin Package, 3.3 to 1.8V, 2.15 x 1.4mm | Texas Instruments | TPS71518DCKR | SL00260
6 | R6, R7, R8, R24, R26, R27 | R6,R7,R8,R26 | SMD-RES-0R-5%-1/16W(0402) | Yageo | RC0402JR-070RL
2 | R3, R4 |  | SMD-RES-1.5K-5%-1/16W(0402) | Yageo | RC0402JR-071K5L
21 | C1, C3, C5, C6, C7, C10, C12, C13, C14, C16, C19, C21, C22, C25, C26, C27, C28, C29, C30, C31, C32 |  | CERAMIC 100NF-10V-10%-X5R(0402) | Yageo | CC0402KRX5R6BB104
2 | R1, R23 |  | SMD-RES-10KOHM-1%-1/10W(0603) | Yageo | RC0603FR-0710KL
1 | C8 |  | CERAMIC-10NF-50V-10%-X7R(0402) | Yageo | CC0402KRX7R9BB103
6 | C4, C11, C15, C18, C23, C33 |  | Tantalum Capacitors - Solid SMD 10uF 6.3V 20% 0402, 1.1x0.6x0.35mm | AVX | F980J106MUALZT
4 | C2, C9, C20, C24 |  | CERAMIC-1UF-10V-10%-X5R(0402) | Yageo | CC0402KRX5R6BB105
15 | R2, R5, R9, R10, R11, R12, R13, R14, R15, R16, R17, R18, R19, R20, R21 |  | SMD-RES-22R-1%-1/16W(0402) | Yageo | RC0402FR-0722RL
1 | C17 |  | CERAMIC 470NF-6.3V-10%-X5R(0402) | Yageo | CC0402KRX5R5BB474
1 | R22 |  | SMD-RES-62K-1%-1/10W(0603) | Yageo | RC0603FR-0762KL
1 | R25 |  | SMD-RES-680R-1%-1/10W(0603) | Yageo | RC0603FR-07680RL
2 | D1, D2 |  | DIODE SCHOTTKY 10V 3A SOD323 | STMicroelectronics | BAT60JFILM
1 | J2 |  | 1.25 MM SIDE-ENTRY 6-PIN SMT CONNECTOR | JST | SM06B-GHS-TB
1 | J3 |  | 1.25mm Pitch PicoBlade Header, Surface Mount, Right-Angle, 3 Circuits, Tin (Sn) Plating | MOLEX | 532610371
3 | J4, J5, J6 |  | 1.25mm Pitch PicoBlade Header, Surface Mount, Right-Angle, 4 Circuits, Tin (Sn) Plating | MOLEX | 532610471
1 | SKT1 |  | PT-LH001P Plastic M12 Lens Holder, 20mm Hole Spacing | M12 LENSES | PT-LH001P
1 | S1 |  | Momentary Switch (Pushbutton) - SPST - SMD - 4.6X2.8MM | C&K | KMR221GLFS
1 | U10 |  | Cap-Free, NMOS, 400-mA Low-Dropout Regulator with Reverse Current Protection 5.5 to 3.3V, SOT-23 5-pin, 2.9 x 1.6 mm | Texas Instruments | TPS73633DBVR
3 | U8, U9, U11 |  | TXS0102 2-Bit Bidirectional Voltage-Level Translator for Open-Drain and Push-Pull Applications | Texas Instruments | TXS0102DQM
