phamtaiece/Capstone-Sightline/EAGLE files/Capstone BOM Feedback.xlsx

Sheet: Sheet1
Ref | Qty | SLPN | MPN
U4 | 1 | SL00740 | AP7331-WG-7
U1 | 1 |  | Need orderable part numbers
U6 | 1 |  | Need orderable part numbers
J1 | 1 | SL00297 | DF12B-50DS-0.5V(86)
OSC1 | 1 |  | KC2520B27.0000C2GE00
LED1 | 1 |  | Please pick something | LEDCHIP-LED0603 | What color? We have a red, green or blue
MTG1, MTG2, MTG3, MTG4 | 4 |  | Please pick something | We have PEM SMTSO-M1.6-3ET or SMTSO-M1.6-2ET (https://catalog.pemnet.com/item/all-categories/surface-mount-nuts---standoffs---br--type-smtso-me/smtso-m1-6-2et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)
U7 | 1 |  | SN74AUC1G08DBVR
U5 | 1 |  | SN74AUC1G17DBV
U3 | 1 | SL00260 | TPS71518DCKR
R6, R7, R8, R24 | 4 |  | RC0402JR-070RL
R3, R4 | 2 |  | RC0402JR-071K5L
C1, C3, C5, C6, C7, C10, C12, C13, C14, C16, C19, C21, C22, C25, C26, C27, C28, C29, C30, C31, C32 | 21 |  | CC0402KRX5R6BB104
R1, R23 | 2 | Nope | Please pick something | 10KOHM-0603-1/10W-1%
C8 | 1 |  | CC0402KRX7R9BB103
C4, C11, C15, C18, C23 | 5 |  | F980G106MUA | No stock, please select another part
C33 | 1 |  | F980G106MUALZT
C2, C9, C20, C24 | 4 |  | CC0402KRX5R6BB105
R2, R5, R9, R10, R11, R12, R13, R14, R15, R16, R17, R18, R19, R20, R21 | 15 |  | RC0402FR-0722RL
C17 | 1 | Nope | Please pick something | 470NF-0402-16V-10%
R22 | 1 | Nope | Please pick something | 62KOHM-0603-1/10W-5%
R25 | 1 | Nope | Please pick something | 680OHM-0603-1/10W-5%
D1, D2 | 2 |  | BAT60JFILM
J2 | 1 |  | SM06B-GHS-TB(LF)(SN)
J3 | 1 |  | 532610371
J4, J5, J6 | 3 |  | 532610471
SKT1 | 1 |  | Please pick something
TP1, TP2, TP3 | 3 | We do not typically populate test points. Do you want to?
S1 | 1 |  | Please pick something
U10 | 1 |  | TPS73633DBVR
U8, U9, U11 | 3 |  | TXS0102DQM

Sheet: 0603 LED
SLA PART NUMBER | MFG PART NO | Package | Mfg
SL00017 | PG1111C-TR | Diode LED_0603-1 GREEN | STANLEY
SL00017 (B) | PG1111C-11-TR | LED GREEN 0603 SMD | Stanley Electric Co
SL00018 | BR1111C-TR | Diode LED_0603-1 RED | STANLEY
SL00402 | LTST-C190GKT | LED GREEN CLEAR 0603 SMD | Lite-On
SL00403 | LTST-C191KRKT | LED SUPER RED CLR THIN 0603 SMD | Lite-On
SL00685 | LTST-C191TBKT | LTST-C191TBKT LED BLUE CLEAR 0603 SMD | Lite On
SL00686 | LTST-S270TBKT | LTST-S270TBKT LED BLUE CLEAR 0603 R/A SMD | Lite On
SL00687 | LTST-S270KRKT | LTST-S270KRKT LED RED CLEAR 0603 R/A SMD | Lite On
