phamtaiece/Capstone-Sightline/Quad_Copter/Capstone_Quadcopter_Bill of Materials.xlsx

Project |  | Capstone Quadcopter |  |  | Sightline
Hardware Revision |  | V
Date (MM/DD/YY) |  | 2019-01-31
Item | Vendor | Quantity | Description | Vendor Link | Mfg | ASIN # | Weight (g) | Cost Per Item | Total Cost | Shipping Time
1 | AMAZON | 1 | DJI FLAMEWHEEL F450 ARF KIT | AMAZON LINK (https://www.amazon.com/DJI-Flame-Wheel-Frame-Motor/dp/B07B65H98Z) | DJI | B07B65H98Z | 604.4 | $229.00 | $229.00 | 1-2 Weeks
2 | AMAZON | 1 | DJI FLAMEWHEEL LANDING GEAR (4 pcs) | AMAZON LINK (https://www.amazon.com/DJI-Flame-Wheel-Landing-Gear/dp/B00GNMLPY4) | DJI | B00GNMLPY4 | 60 | $17.50 | $17.50 | 2-3 Days (Prime)
3 | AMAZON | 1 | FrSky Taranis X9D Plus 16-Channel 2.4ghz ACCST Radio Transmitter | AMAZON LINK (https://www.amazon.com/FrSky-Taranis-16-Channel-2-4ghz-Transmitter/dp/B00MYORSW8) | FrSky | B00MYORSW8 | N/A | $229.00 | $229.00 | 2-3 Days (Prime)
4 | AMAZON | 1 | FrSky X4RSB 3/16CH Telemetry Receiver Full Range | AMAZON LINK (https://www.amazon.com/FrSky-X4RSB-Telemetry-Receiver-Range/dp/B00VM1XWB0?s=toys-and-games) | FrSky | B00VM1XWB0 | 5.8 | $31.99 | $31.99 | 2-3 Days (Prime)
5 | AMAZON | 2 | Gens ace 14.8V 5000mAh 45C 4S LiPo Battery Pack | AMAZON LINK (https://www.amazon.com/Gens-5000mAh-Battery-LOGO500-T-REX550/dp/B06Y4BRD2B) | Gens Ace | B06Y4BRD2B | 480 | $64.99 | $129.98 | 2-3 Days (Prime)
6 | SPARKFUN | 1 | PIXHAWK 4 ADVANCED DEVELOPMENT KIT | SPARKFUN LINK (https://www.sparkfun.com/products/14841) | HOLYBRO | N/A | 200 | $210.95 | $210.95 | 1-2 Weeks
7 | AMAZON | 1 | Tenergy TB6-B Balance Charger Discharger 1S-6S Digital Battery Pack Charger | AMAZON LINK (https://www.amazon.com/dp/B00466PKE0/ref=sspa_dk_detail_7?psc=1&pd_rd_i=B00466PKE0) | Tenergy | B00466PKE0 | N/A | $54.99 | $54.99 | 2-3 Days (Prime)
8 | SPARKFUN | 1 | PIXHAWK 4 RADIO TELEMETRY KIT | SPARKFUN LINK (https://www.sparkfun.com/products/15007) | HOLYBRO | N/A | 15 | $39.95 | $39.95 | 1-2 Weeks
9 | AMAZON | 1 | XT-60 CONNECTORS MALE/FEMALE | AMAZON LINK (https://www.amazon.com/Upgrade-XT60-Connectors-Female-Male/dp/B07HPC3JQK) | MakerDoIt | B07HPC3JQK | 12 | $11.99 | $11.99 | 2-3 Days (Prime)
10 | AMAZON | 1 | Prop Guards for DJI Flamewheel F450 | AMAZON LINK (https://www.amazon.com/SummitLink-Tool-Free-Quick-Guards-Flamewheel/dp/B07M91QV8F) | Summit Link | B07M91QV8F | 120 | $19.95 | $19.95 | 2-3 Days (Prime)
11 | Holybro | 1 | PX4FLOW KIT camera + sonar | HOLYBRO LINK (https://shop.holybro.com/px4flow-kit_p1035.html) | HOLYBRO | N/A | 19 | $126.50 | $126.50 | 1-2 Weeks
12 | AMAZON | 1 | RAYCorp 9450 Self-Tightening (9.4x5) Propellers. 8 Pieces(4CW, 4CCW) | AMAZON LINK (https://www.amazon.com/RAYCorp-Self-Tightening-9-4x5-Propellers-Pieces/dp/B07H1H9SPK?s=toys-and-games) | RAYCORP | B07H1H9SPK | N/A | $13.99 | $13.99 | 2-3 Days (Prime) | ESTIMATED WEIGHT (g) | 1516.2
 |  |  |  |  |  |  |  |  |  |  | Total Cost | $1115.79
