phamtaiece/Capstone-Sightline/AR0134CS/Capstone_AR0134CS_BOM.xlsx

Project |  |  | Capstone Quadcopter |  |  |  |  | Sightline
Hardware Revision |  |  | III
Date (MM/DD/YY) |  |  | 2019-01-01
Item | Vendor | Vendor Link | Quantity | Description | Value | Tolerance | Footprint | Mfg | Mfg Part # | P/DNP | Eagle Footprint | Cost per Item | Total Cost | Shipping Time
1 |  |  | 1 | CAP, CERAMIC, 1uF, 25V, X7R, 10%, 0805 | 1 uF | 10% | 805 | Murata | GCM21BR71E105KA56L
2 |  |  | 33 | CAP, CERAMIC, 100nF, 10V, X5R, 20%, 0201 | 100 nF | 20% | 201 | Panasonic | ECJZEB1A104M
3 |  |  | 18 | CAP, TANTALUM CHIP, STD, 10uF, 10V, 10%, 3216 | 10 uF | 10% | 3216-18 | AVX | TAJA106K010R
4 |  |  | 6 | CAP, TANTALUM CHIP, LOW ESR, 10uF, 10V, 10%, 3216 | 10 uF | 10% | 3216-18 | AVX | TPSA106K010R0900
5 |  |  | 1 | DIODE, LED, CHIP, GRN, CLEAR LENS, 2.0V, 20mA, SMD, 0603 | GRN |  | 603 | Lite-On | LTST-C190KGKT
6 |  |  | 1 | IND, FERRITE CHIP, 220 OHM AT 100MHz, 0.1 OHM DC, 0603 | 1.4 A |  | 603 | Murata | BLM18PG221SN1D
7 |  |  | 4 | RESISTOR, CHIP ARRAY, ISOLATED, 4 RES, 8 TERMINALS, 22 OHM, 0.063W, 5%, 0402 ARRAY | 22 | 5% | 0402 X 4 | Panasonic | EXB28V220JX
8 |  |  | 8 | RESISTOR, THICK FILM CHIP, SMD, 10K, 0.063W, 5%, 0402 | 10K | 5% | 402 | Panasonic | ERJ2GEJ103X
9 |  |  | 1 | RESISTOR, THICK FILM CHIP, SMD, 0 OHM JUMPER, 0.1W, 5%, 0603 | 0 | 5% | 402 | Panasonic | ERJ3GEY0R00V
10 |  |  | 1 | RESISTOR, THICK FILM CHIP, SMD, 560 OHM, 0.063W, 5%, 0402 | 560 | 5% | 402 | Panasonic | ERJ2GEJ561X
11 |  |  | 2 | RESISTOR, THICK FILM CHIP, SMD, 20K, 0.1W, 5%, 0603 | 20K | 5% | 603 | Panasonic | ERJ3GEYJ203V
12 |  |  | 3 | RESISTOR, THICK FILM CHIP, SMD, 33 OHM, 0.063W, 5%, 0402 | 33 | 5% | 402 | Panasonic | ERJ2GEJ330X
13 |  |  | 3 | RESISTOR, THICK FILM CHIP, SMD, 0 OHM JUMPER, 0.063W, 5%, 0402 | 0 | 5% | 402 | Panasonic | ERJ2GE0R00X
14 |  |  | 1 | SWITCH, PUSH BUTTON, SEALED TACTILE, MOM, 2 PIN, SPST-NO, 0.05A @ 12VDC, SMD | PB-SPST |  |  | C&K Components | PTS635SL25SMTRLFS
15 |  |  | 2 | CONN, TERMINAL, TEST POINT COMPACT, .015 THICK, SMT | TSTPT-5016 |  |  | Keystone Electronics | 5016
16 |  |  | 1 | IC, VOLTAGE REGULATOR, POSITIVE, VLDO, ADJ, 100mA, 0.2 TO 9.5V OUTPUT, MSOP8 | LT3020EMS8-ADJ |  | MSOP8 | Linear Technology | LT302OEMS8#PBF
17 |  |  | 2 | IC, BUFFER, SINGLE SCHMITT-TRIGGER, 9mA, 0.8V TO 2.7V, SOT23-5 | SN74AUC1G17 |  | SOT23-5 | Texas Instruments | SN74AUC1G17DBVR
18 |  |  | 1 | IC, AND GATE, SINGLE, 2 INPUT POSITIVE, SGL, SC70-5 | SN74AUC1G08 |  | SOT23-5 | Texas Instruments | SN74AUC1G08DBVR
19 |  |  | 1 | IC, SUPERVISOR, MICROPROCESSOR POWER SUPPLY, 2.93V, ACTIVE LOW RESET, SOT143-4 | CAT811 |  | SOT143-4 | ON Semiconductor | CAT811STBI
20 |  |  | 1 | IC, SERIAL EEPROM, I2C, 64Kbit, 2.5V, 1MHz, -40°C ~ 85°C, SO8 | 24FC64-I/SN |  | SO8 | Microchip | 24FC64-I/SN
21 |  |  | 1 | OSC, CRYSTAL CLOCK, SMD, CMOS, 2.25V TO 3.63V, 4mA, 27.0000MHz, 2.5MM x 2.0MM | 27MHz |  |  | Kyocera | KC2520B27.0000C2GE00
22 |  |  | 1 | IC, SENSOR, ACTIVE-PIXEL DIGITAL IMAGE, CMOS, C24G, AR0134, iBGA63 | AR0134 |  | iBGA63 | Aptina Imaging/ Micron | AR0134CSS
