phamtaiece/Capstone-Sightline/Sightline Docs/Schematics/SLA-1500-FFC_RevC_Bill of Materials.xlsx

Sheet: BOM
Project |  | SLA-1500-FFC |  |  | RoHS Compliant
Hardware Revision |  | C
Date (MM/DD/YY) |  | 2/8/2016
Item | SLA Part No | Quantity | Description | Designator | Mfg | MfgPartNo
1 | SL00104 | 2 | 1uF Cer, X5R, 10%, 0402, 10V | C1, C2 | Murata | GRM155R61A105KE15D
2 | SL00107 | 2 | 0.01uF Cer, X5R, 10%, 0402, 16V | C3, C4 |  | EMK063BJ103KP-F
3 | SL00548 | 1 | 501912-3990 CONN FPC BOTTOM 39POS 0.30MM R/A | J1 | Molex | 501912-3990
4 | SL00531 | 1 | 53047-0310 3-Pos PicoBlade Thru-Hole Header Vert | J2 | Molex | 53047-0310
5 | SL00311 | 1 | 87224-2 2-Pin 0.1" HEADER VERT | J3 | TE | 87224-2
6 | SL00297 | 1 | DF12B-50DS-0.5V(86) Hirose Male 50-pin connector | J40 | Hirose | DF12B-50DS-0.5V(86)
7 | SL00411 | 1 | FH12-30S-0.5SH(55) - FFC Connector | J73 | Hirose | FH12-30S-0.5SH(55)
8 |  | 4 | M1.6 Plated Clearance Hole | M1, M2, M3, M4 | NA | M1.6
9 |  | 3 | Do Not Populate 0402 Res | R1, R5, R6 | DNI | DNI
10 | SL00128 | 2 | 0 Ohm, 0402 | R3, R4 | Panasonic | ERJ-2GE0R00X
11 | SL00033 | 3 | 0 Ohms, 1/10W, 0603 | R10, R11, R12 | Panasonic | ERJ-3GEY0R00V
12 | SL00502 | 1 | TPS73633DCQR IC REG LDO 3.3V 0.4A SOT223-6 | U1 | Texas Instruments | TPS73633DCQR
13 | SL00549 | 1 | ASEMB-27.000MHZ-XY-T | U2 | Abracon | ASEMB-27.000MHZ-XY-T

Sheet: REV CTRL
Revision Number | Ref Number (date) | Modifier | Changes Made
A | 2/24/14 | ABJ | Initial Release
B | Never Built? | ABJ | Changes made
C | 1/25/16 | ABJ | Added Airborne FFC connector
 | - | - | -
 | - | - | -
 | - | - | -
 | - | - | -
 | - | - | -
 | - | - | -
 | - | - | -
 | - | - | -
 | - | - | -
 | - | - | -
 | - | - | -

Sheet: DNI
Item | Quantity | Description | Designator | Mfg | MfgPartNo | Comment
9 | 3 | Do Not Populate 0402 Res | R1, R5, R6 | DNI | DNI
