phamtaiece/Capstone-Sightline/Final Documentation/Design Report/quad_BOM.PNG

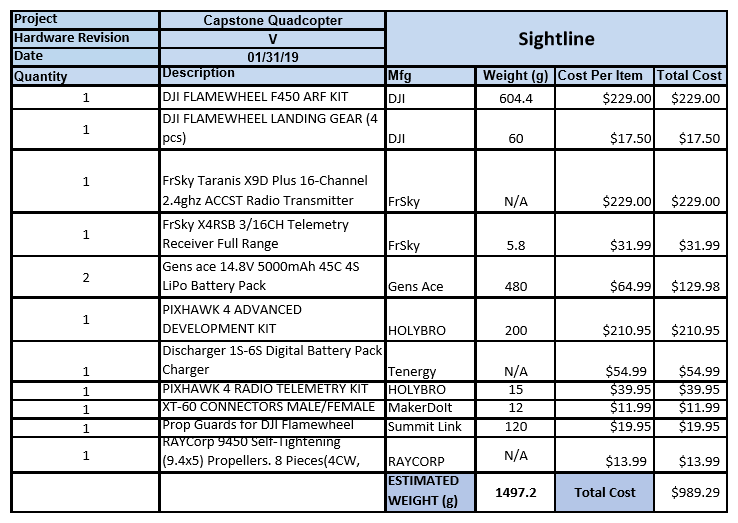
Final Documentation/Design Report/quad_BOM.PNG
