phamtaiece/Capstone-Sightline/Photos/Building A Case for the Quadcopter/IMG-2361.jpg

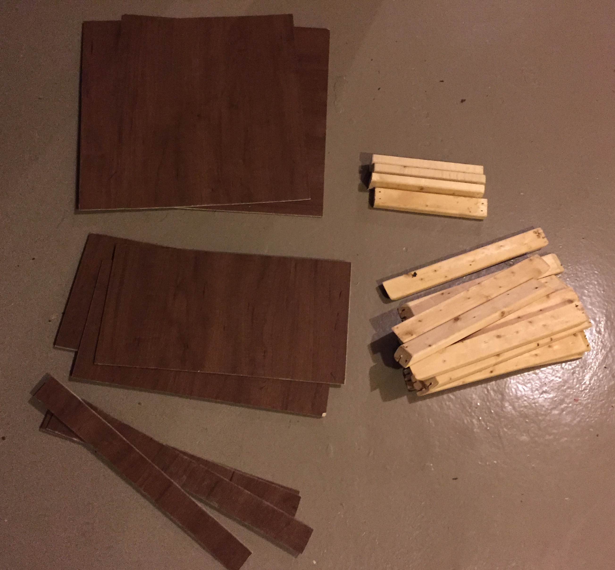
Photos/Building A Case for the Quadcopter/IMG-2361.jpg
