phamtaiece/Capstone-Sightline/Photos/Building A Case for the Quadcopter/IMG-2365.jpg

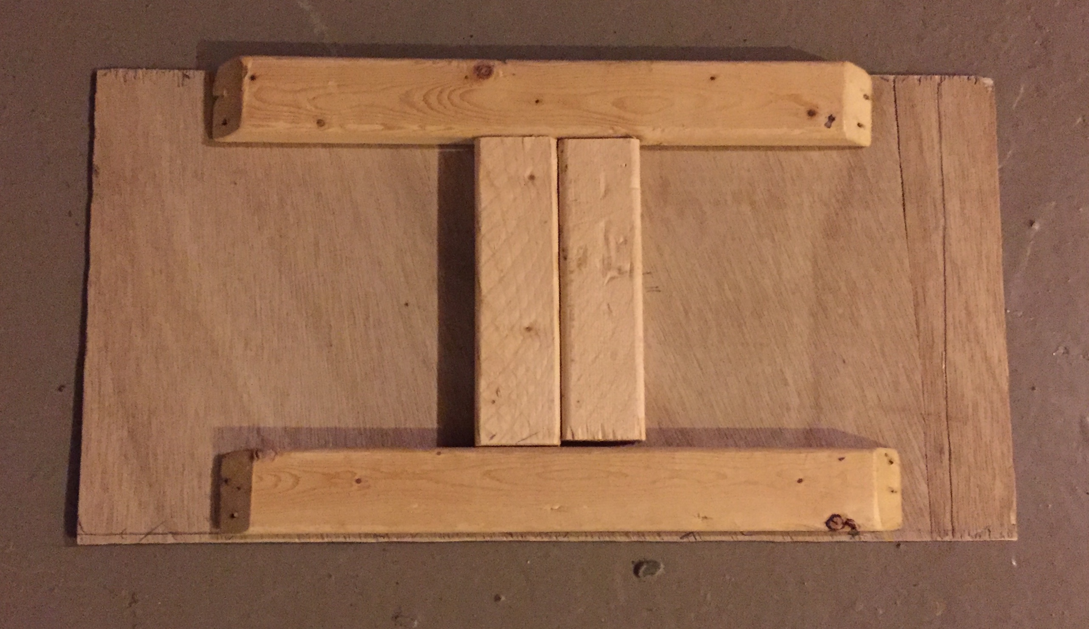
Photos/Building A Case for the Quadcopter/IMG-2365.jpg
