phamtaiece/Capstone-Sightline/Photos/Building A Case for the Quadcopter/IMG-2370.jpg

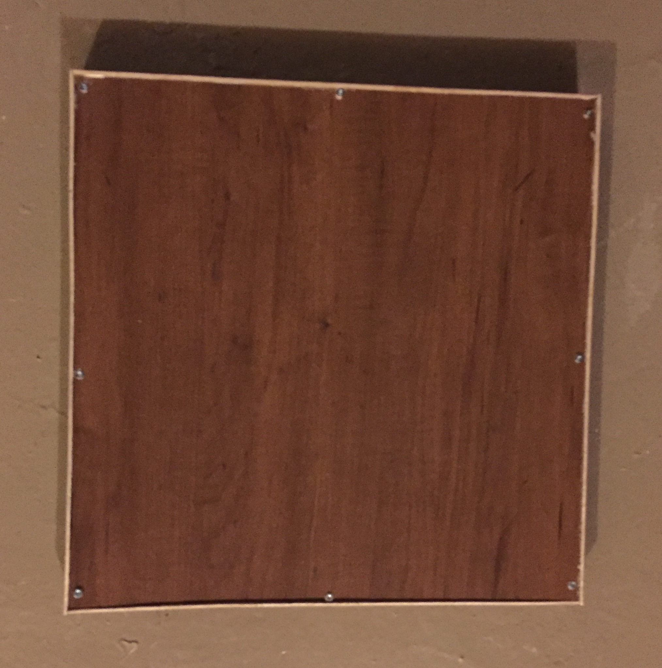
Photos/Building A Case for the Quadcopter/IMG-2370.jpg
