phamtaiece/Capstone-Sightline/Photos/Building A Case for the Quadcopter/IMG-2373.jpg

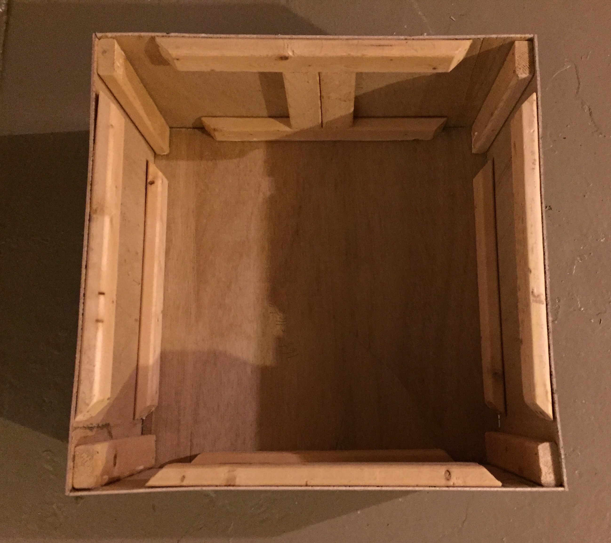
Photos/Building A Case for the Quadcopter/IMG-2373.jpg
