phamtaiece/Capstone-Sightline/Photos/Building A Case for the Quadcopter/IMG-2395.JPG

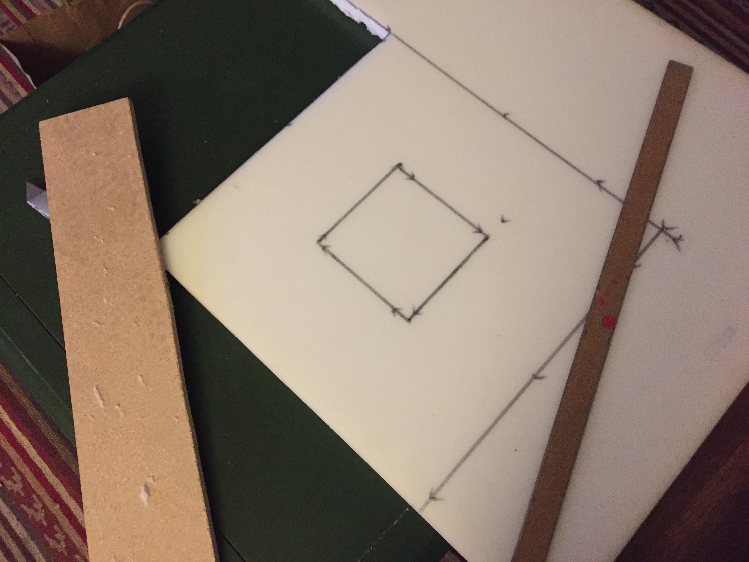
Photos/Building A Case for the Quadcopter/IMG-2395.JPG
