phamtaiece/Capstone-Sightline/Photos/Building A Case for the Quadcopter/IMG-2397.jpg

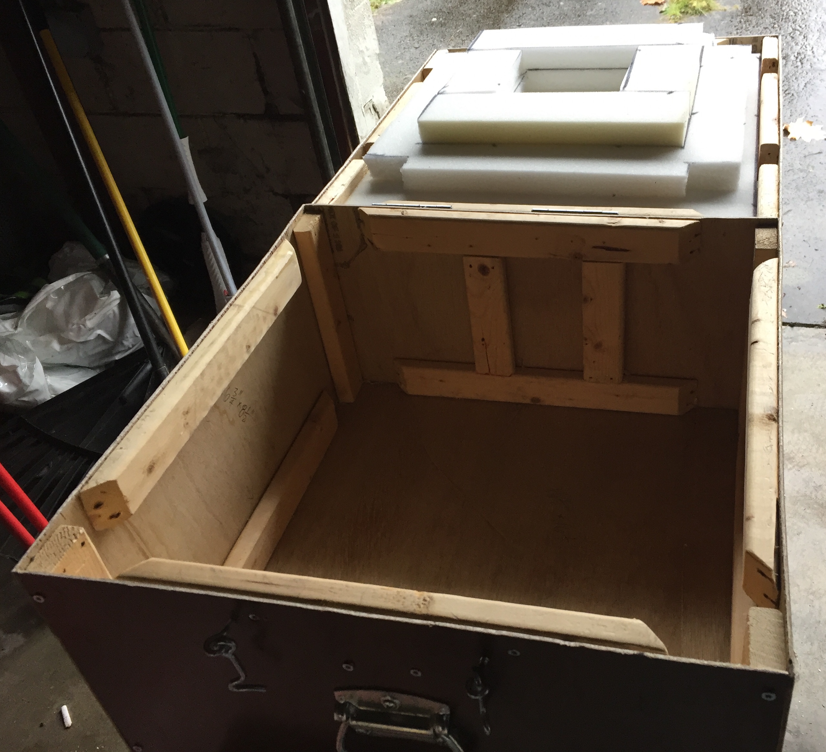
Photos/Building A Case for the Quadcopter/IMG-2397.jpg
