phamtaiece/Capstone-Sightline/Photos/Building A Case for the Quadcopter/IMG-2399.jpg

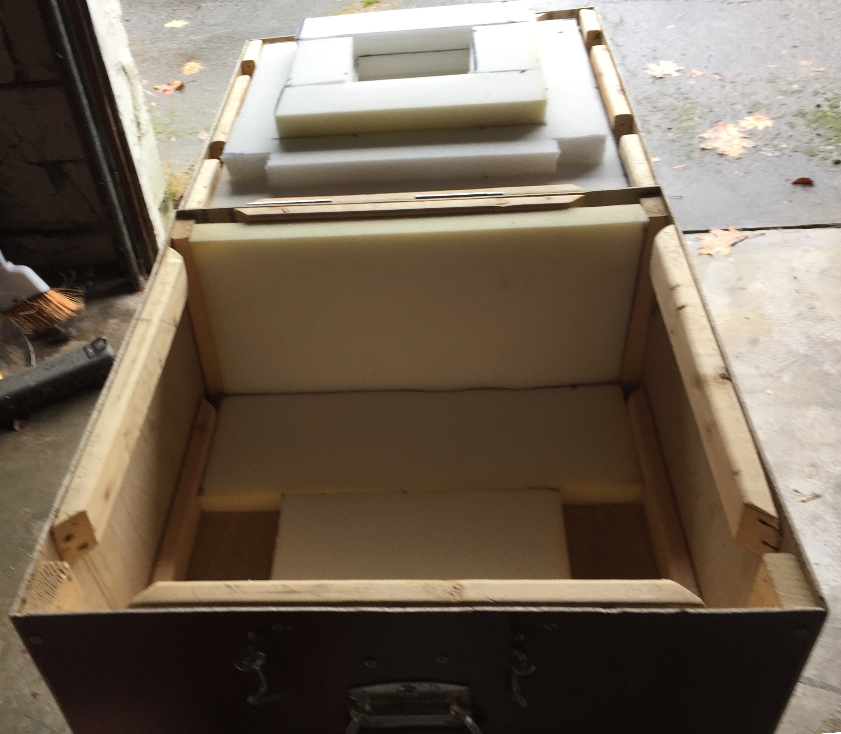
Photos/Building A Case for the Quadcopter/IMG-2399.jpg
