phamtaiece/Capstone-Sightline/Sightline Docs/Schematics/SLA-3000-FPC_RevB_Schematic Prints.PDF

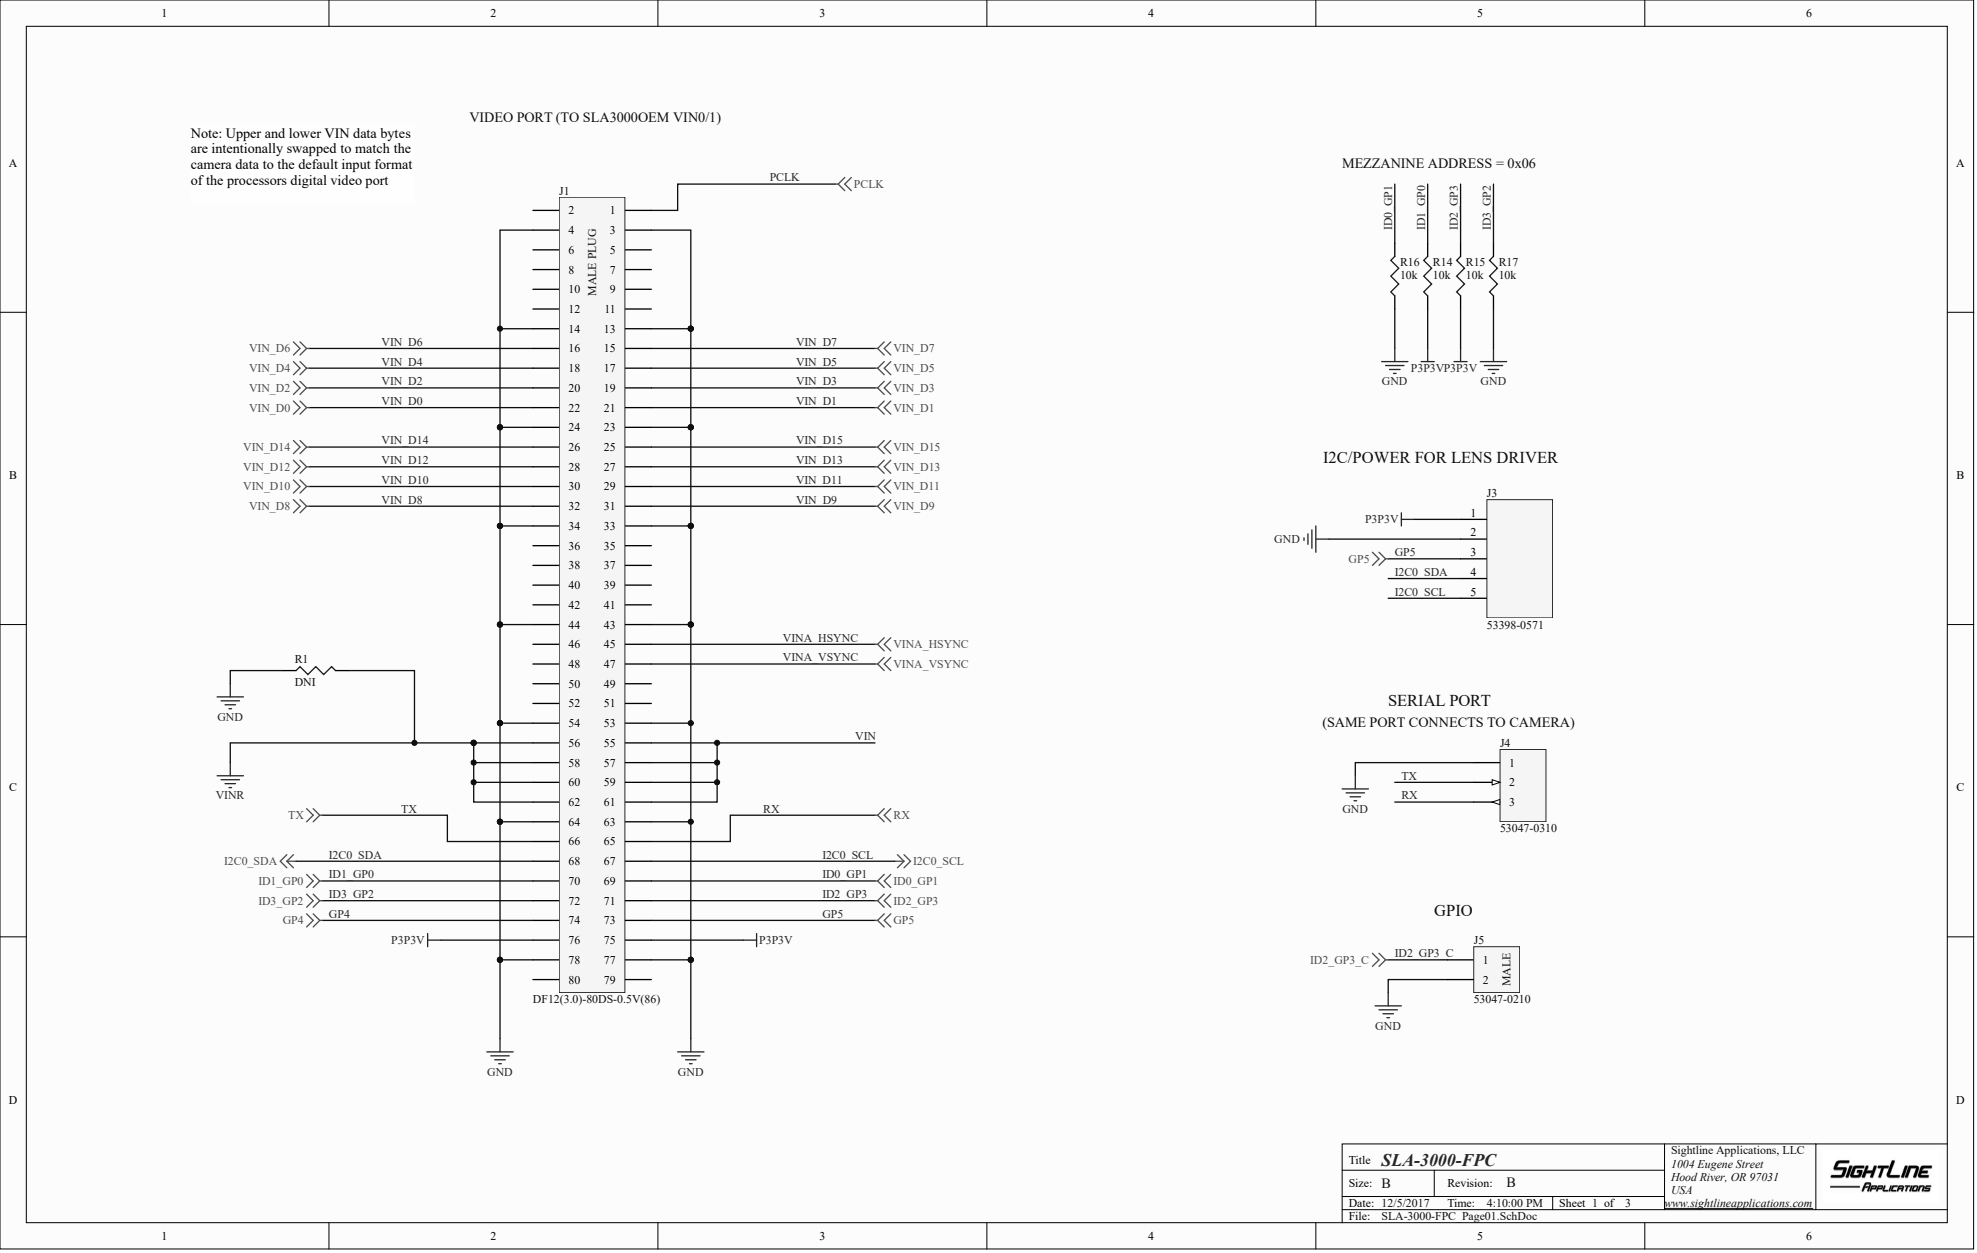
[picture p125: page 1]

Note: Upper and lower VIN data bytes
are intentionally swapped to match the
camera data to the default input format
of the processors digital video port

I2C/POWER FOR LENS DRIVER

Title SLA-3000-FPC | Sightline Applications, L L C 1004 Eugene Street Hood River, OR 97031 USA www.sightlineapplications.com

Size: | B

Date: 12/5/2017 4:10:00 PM | 1

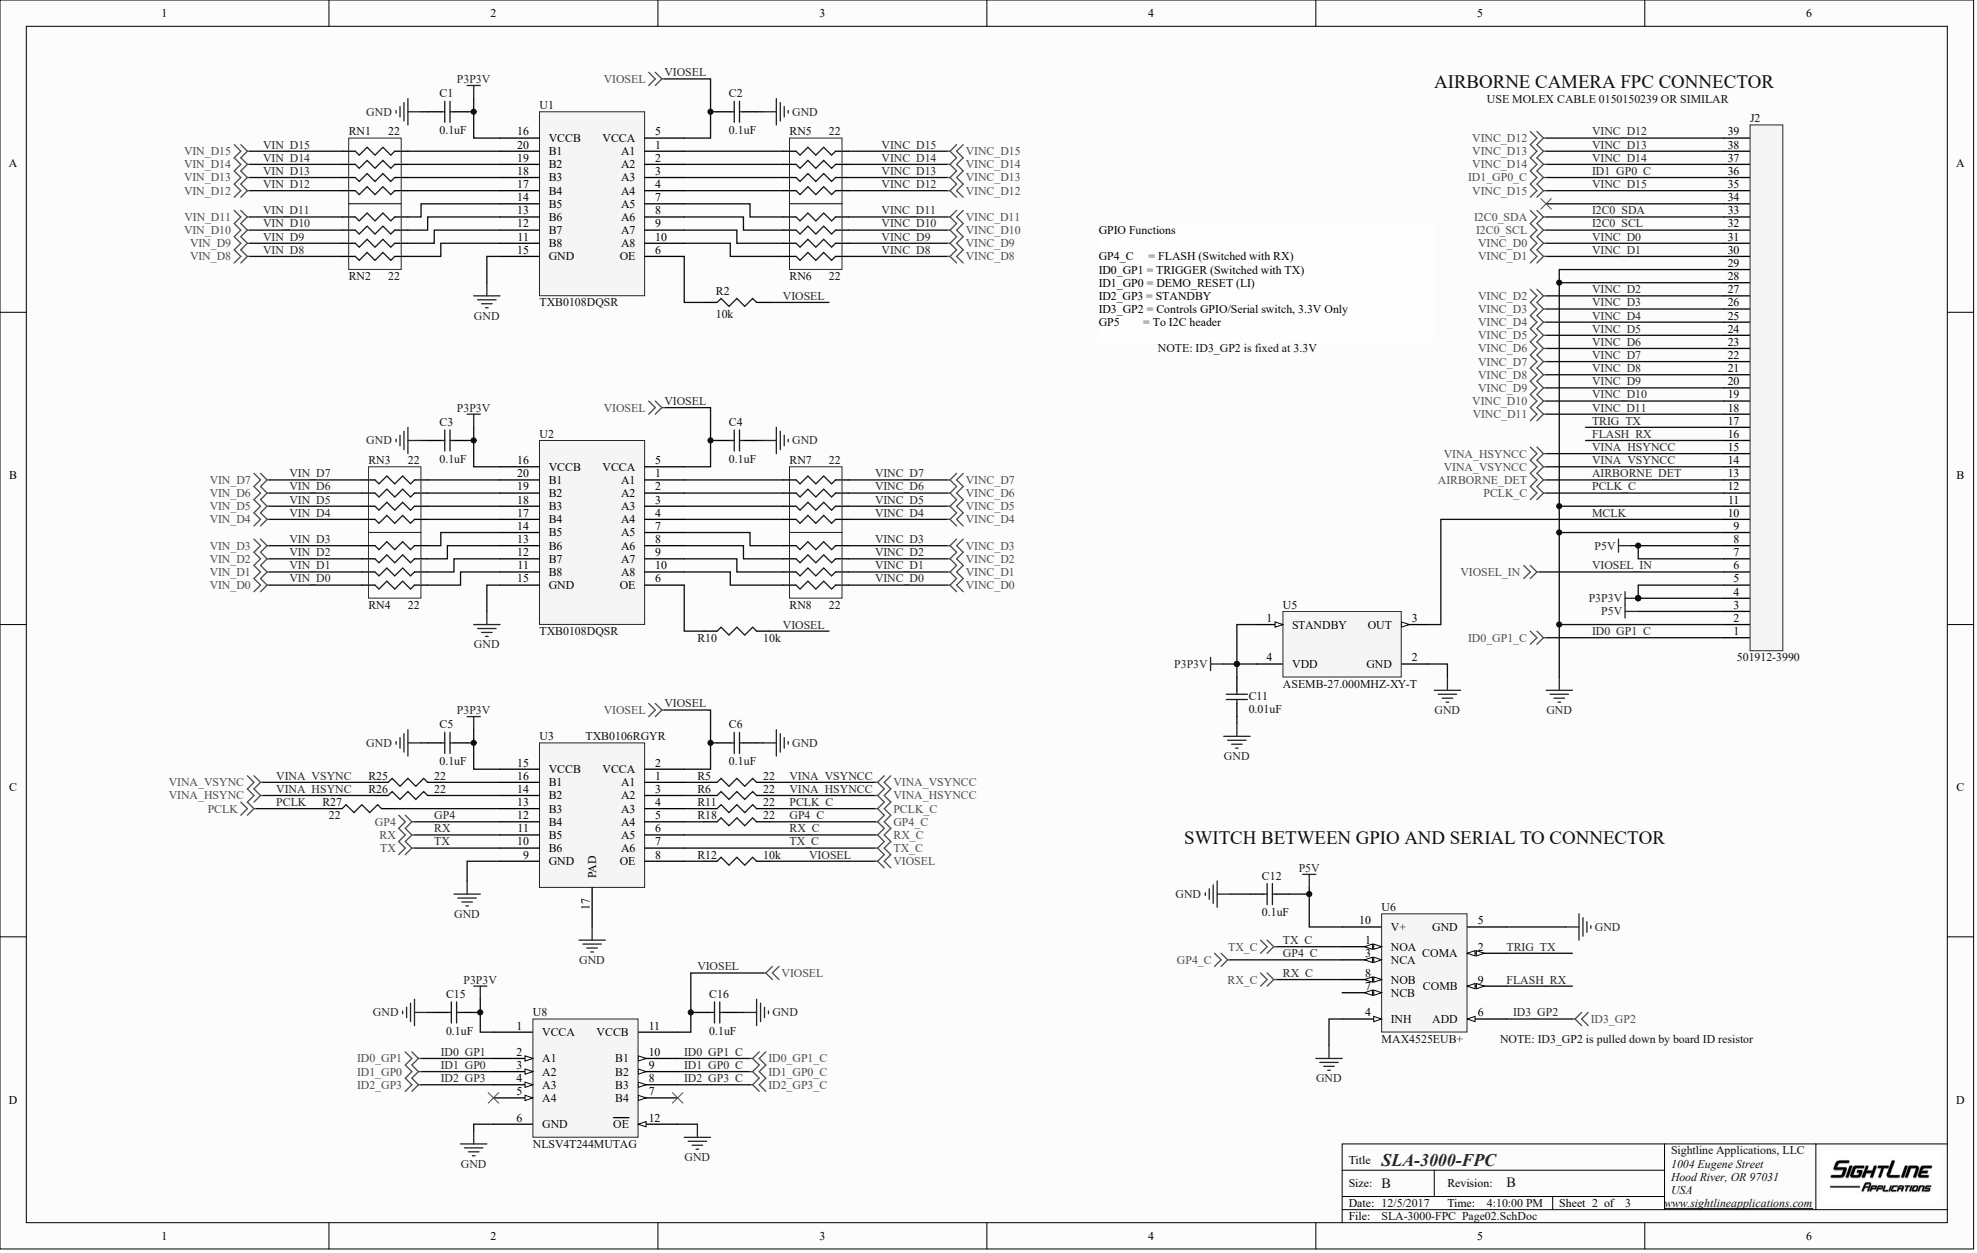
[picture p126: page 2]

USE MOLEX CABLE 0150150239 OR SIMI

ID1_GP0_C ID0_GP1_C VINC_D2 VINC_D3 VINC_D4 VINC_D5 VINC_D6 VINC_D7 VINC_D8 VINC_D9 VINC_D10 VINC_D1 1 | 27 26 25 24 23 22 21 20 19 18 17

TRIG_TX I2C0_SDA I2C0_SCL | 28

NOTE: ID3_GP2 is fixed at 3.3V

GND 15

SWITCH BETWEEN GPIO AND SERIAL

NOTE: ID3_GP2 is pulled down by board ID resistor

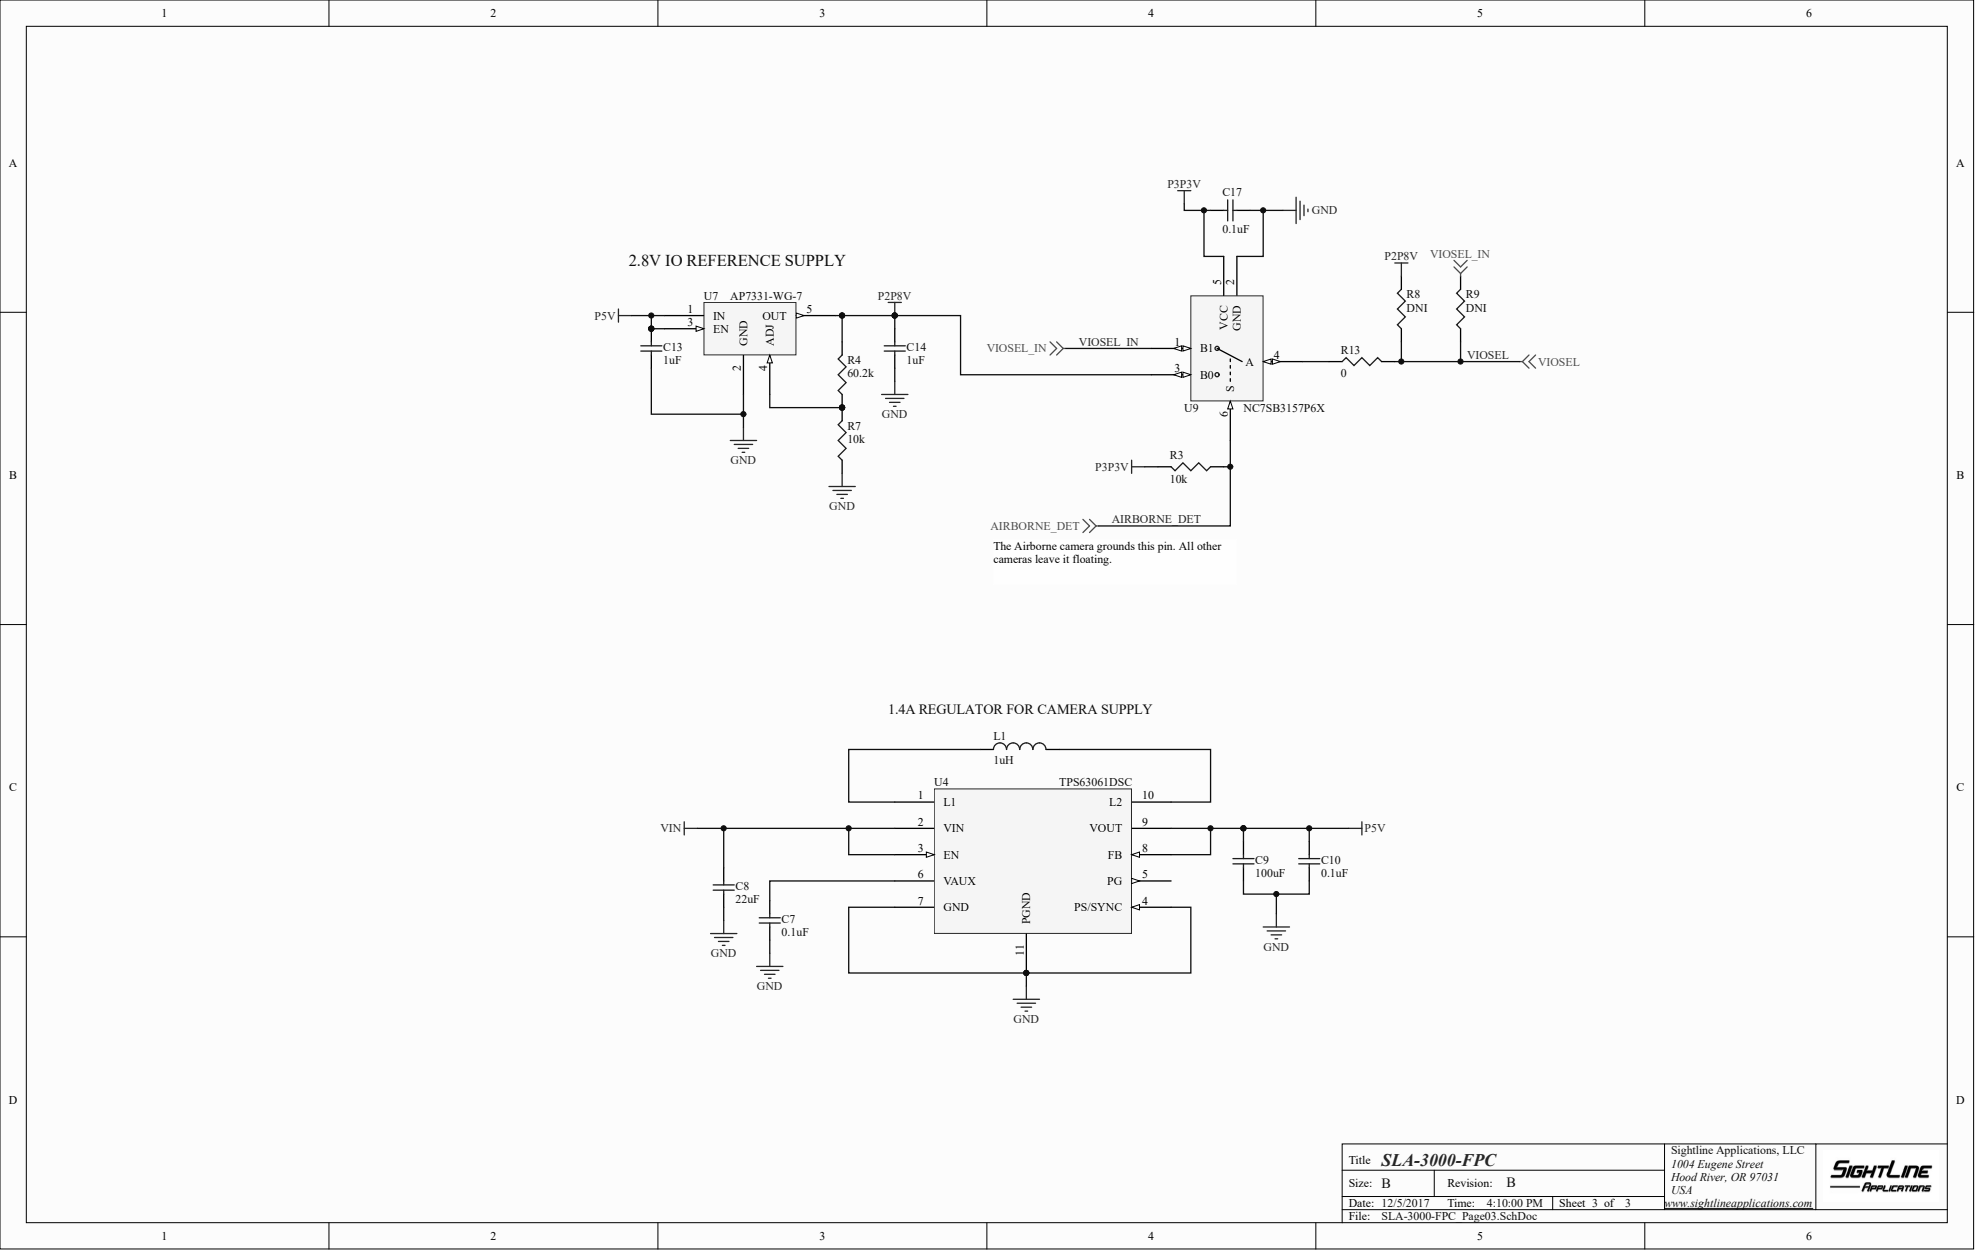
[picture p127: page 3]

The Airborne camera grounds this pin. All other
cameras leave it floating.

1.4A REGULATOR FOR CAMERA SUPPLY

Sightline Applications, LLC

Revision:
Time: | Sheet of
