phamtaiece/Capstone-Sightline/Sightline Docs/Schematics/SLA-FPC-BOSON_Schematic Prints.PDF

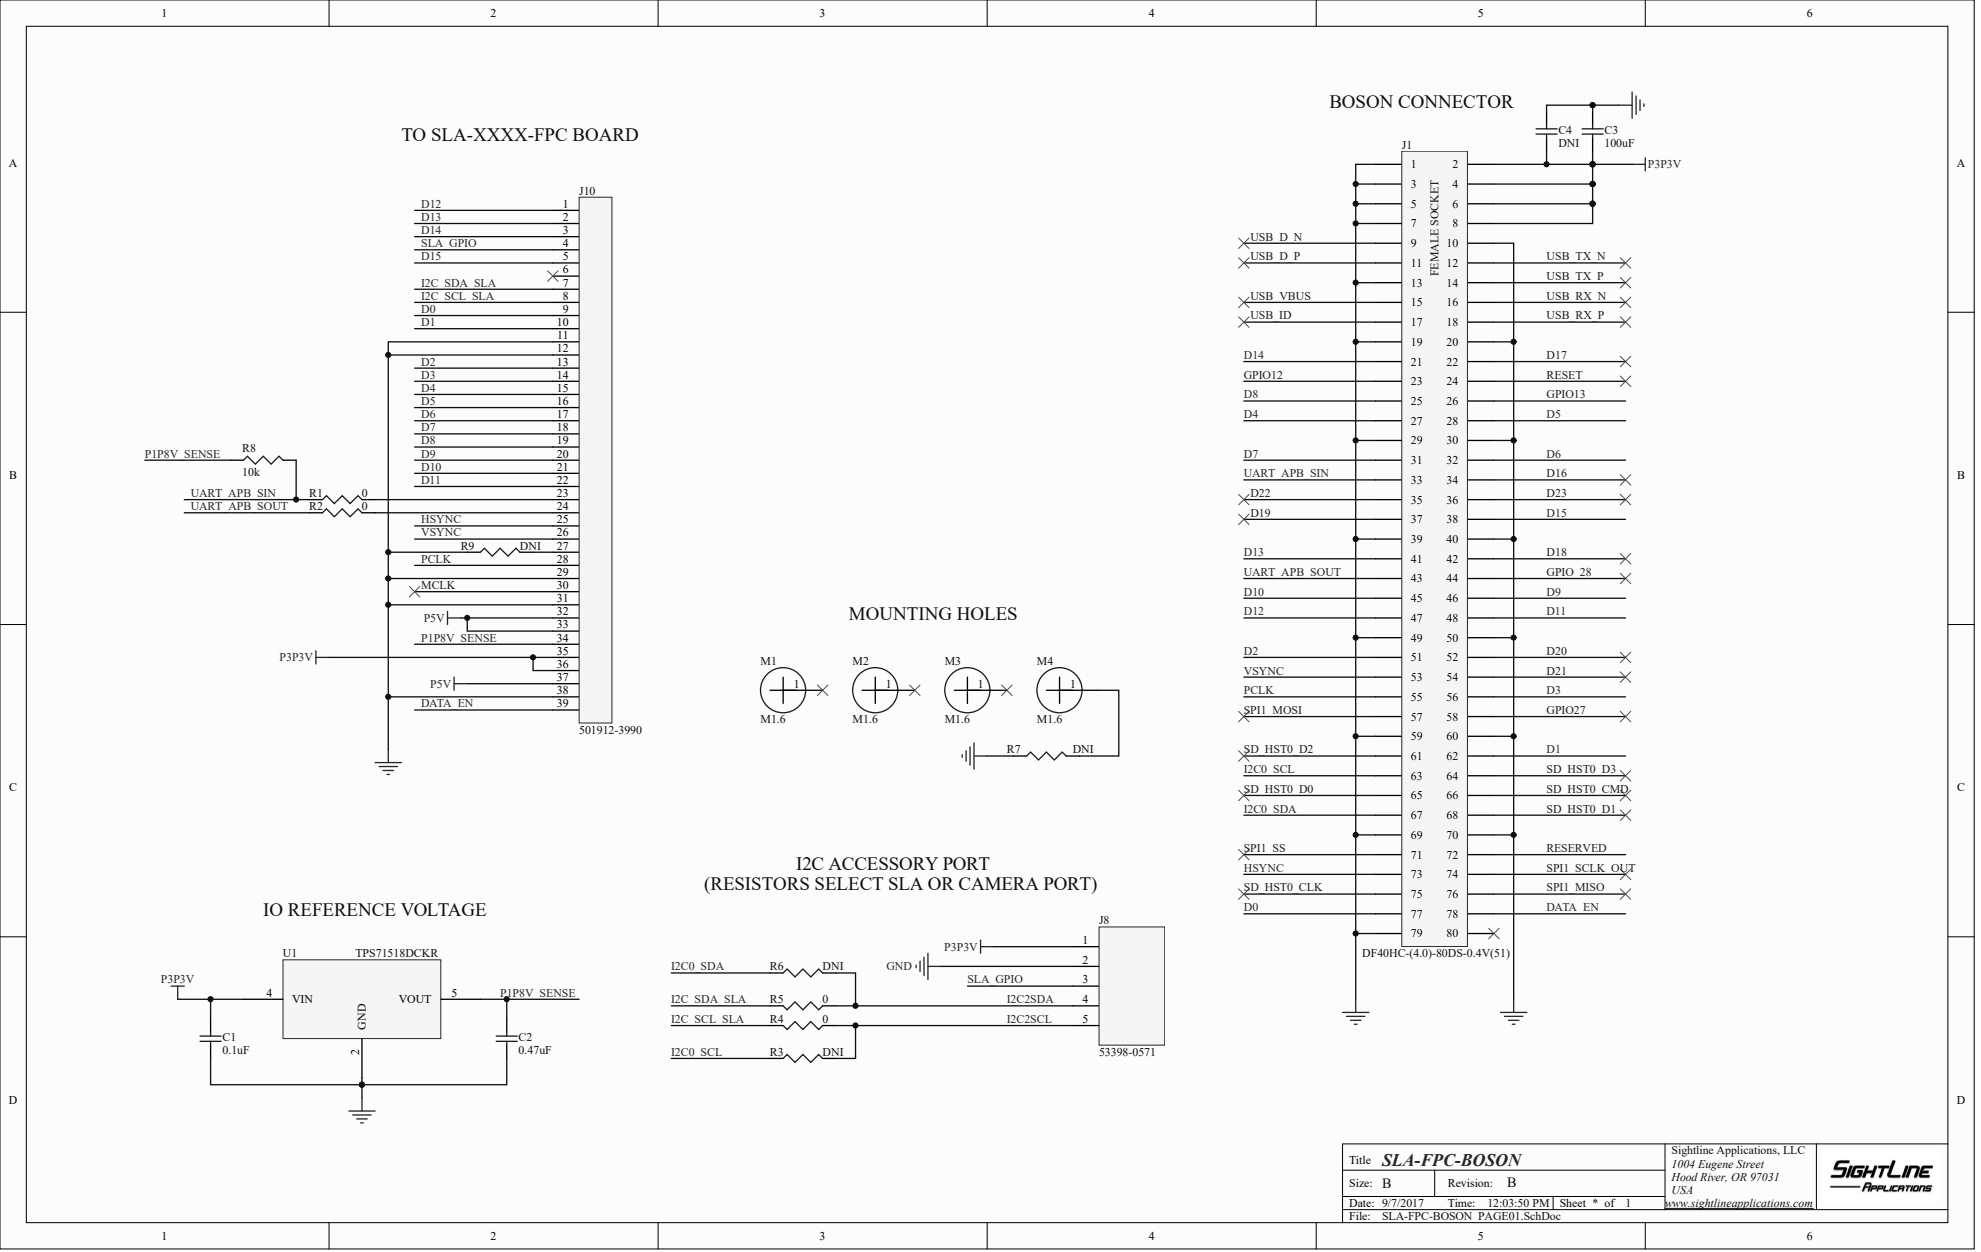
[picture p128: page 1]

TO SLA-XXXX-FPC BOARD

HSYNC VSYNC R9 DNI PCL K | 25 26 27 28 29

MCL K | 30 31

DATA_EN

(RESISTORS SELECT SLA OR CAMERA PORT)

Title SLA-FPC-BOSONB | Sightline Applications, L L C 1004 Eugene Street Hood River, OR 97031 USA www.sightlineapplications.com

Size: B
Date: 9/7/2017 12:03:50 PM | * 1
