phamtaiece/Capstone-Sightline/Sightline Docs/Schematics/SLA-1500-FFC_RevC_Schematic Prints.PDF

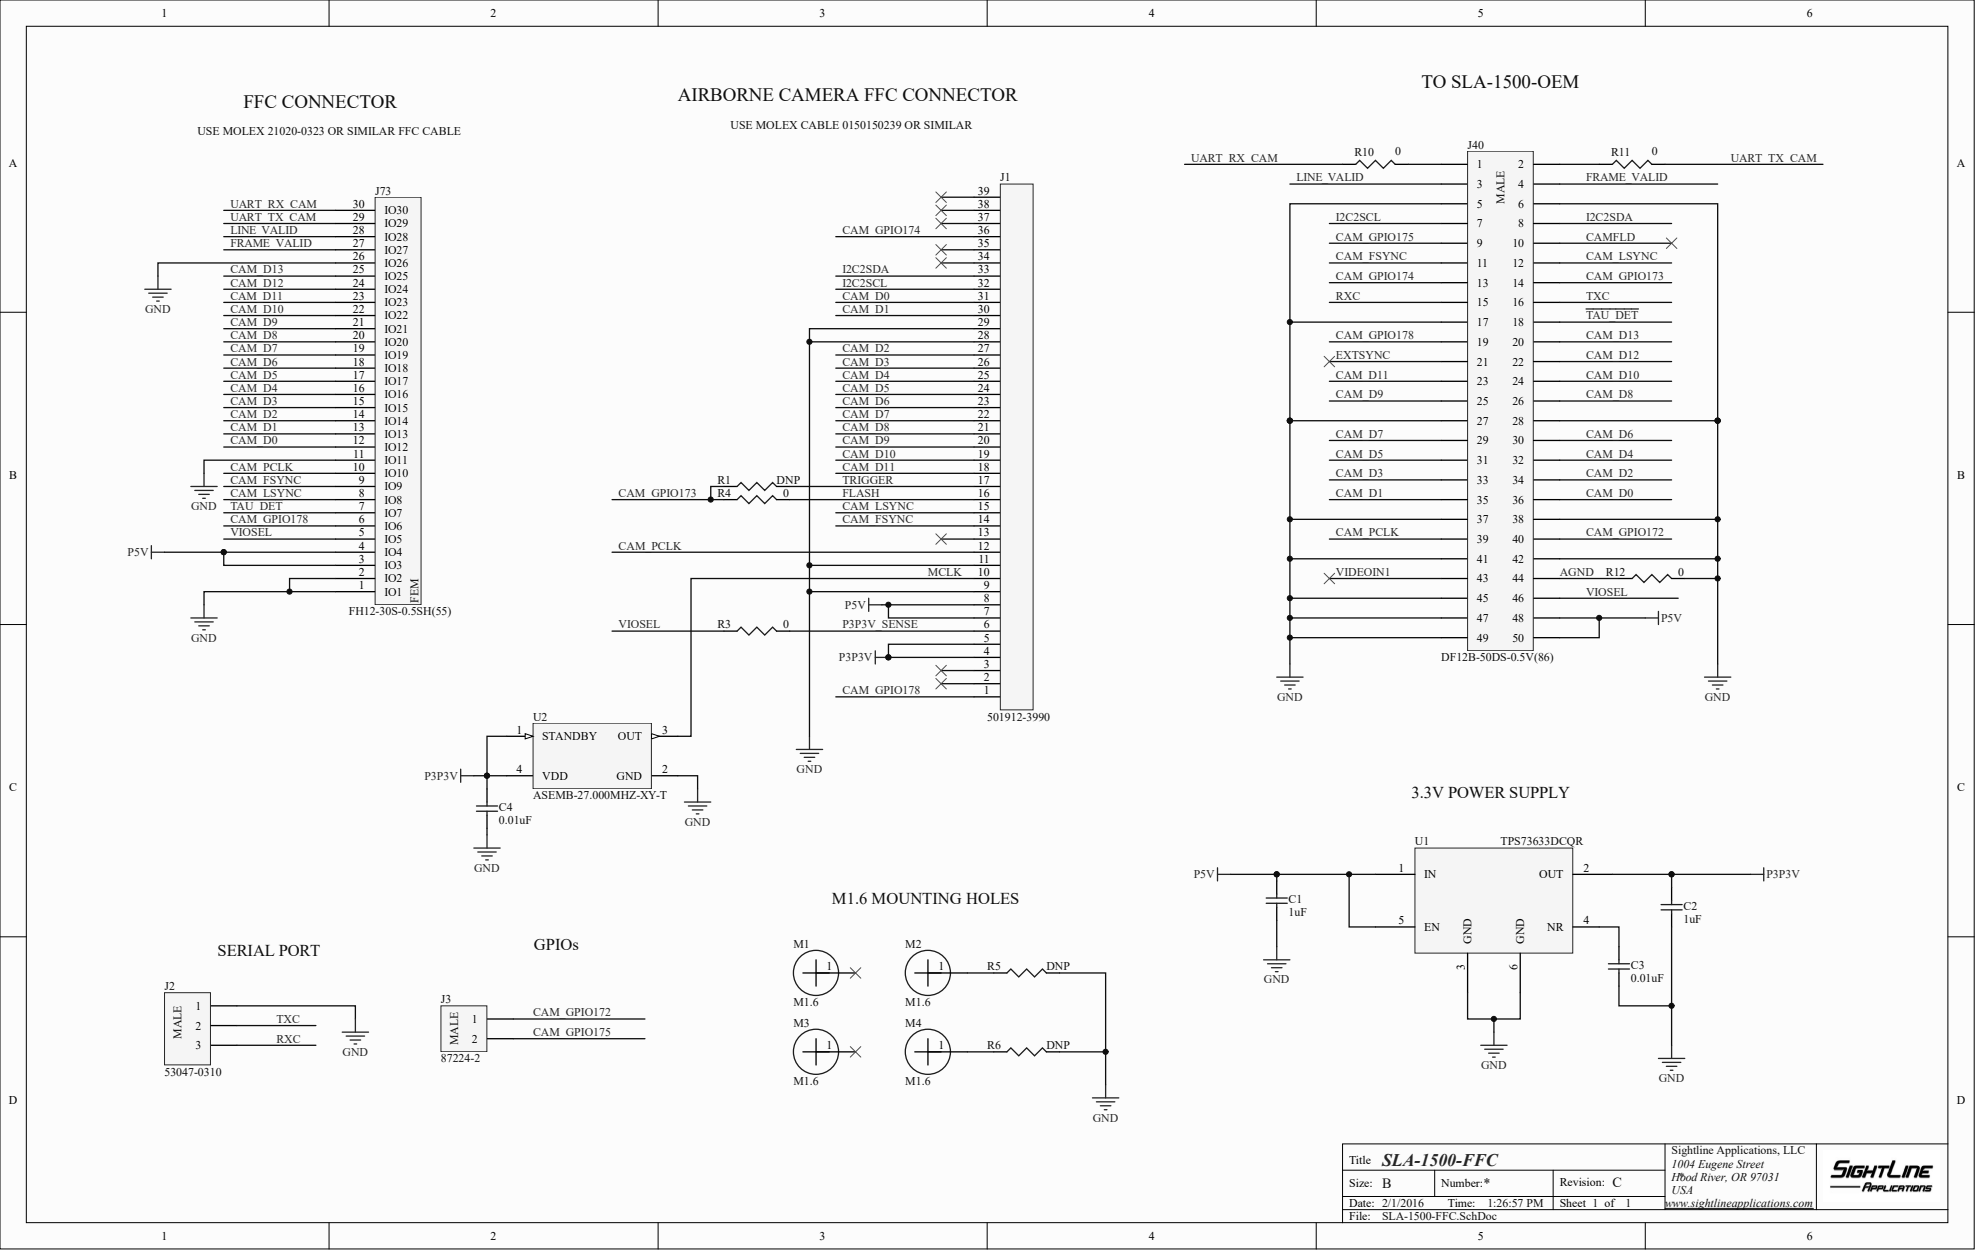
[picture p129: page 1]

AIRBORNE CAMERA FFC CONNECTOR

USE MOLEX 21020-0323 OR SIMI

USE MOLEX CABLE 0150150239 OR SIMI

MCL K

VIDEOIN1 | AGND R12 0 VIOSEL

Title | Sightline Applications, L L C 1004 Eugene Street Hood River * , OR 97031 USA www.sightlineapplications.com

Size: B | Number: | Revision: C

Date: 2/1/2016 Time: 1:26:57 PM | | Sheet 1 of 1
