phamtaiece/Capstone-Sightline/Sightline Docs/Schematics/SLA-1500-FFC_RevC_Dimensioned.pdf

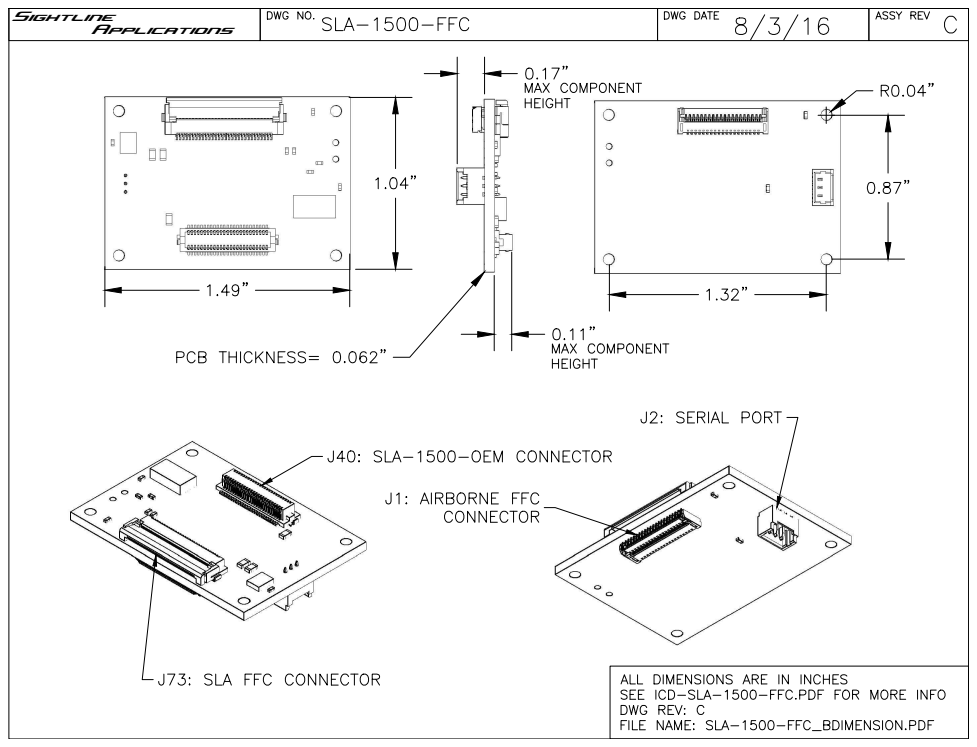
[picture p130: page 1]
