phamtaiece/Capstone-Sightline/EAGLE files/FAB/SLA1500CAM_V8_bttm.pdf

1.49 | 1 ¹ | 1

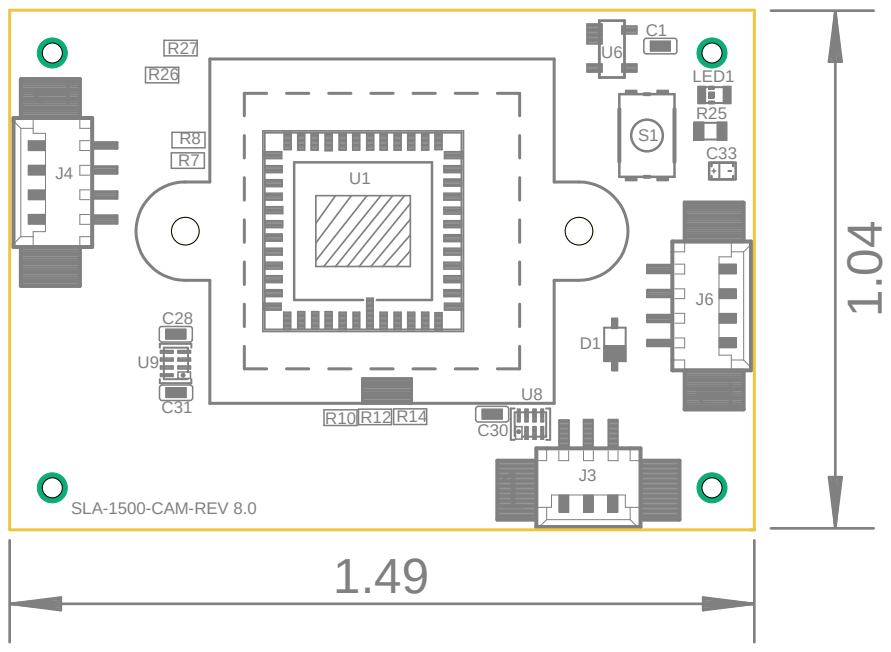
[picture p131: page 1]
