phamtaiece/Capstone-Sightline/EAGLE files/FAB/SLA1500CAM_V8_top.pdf

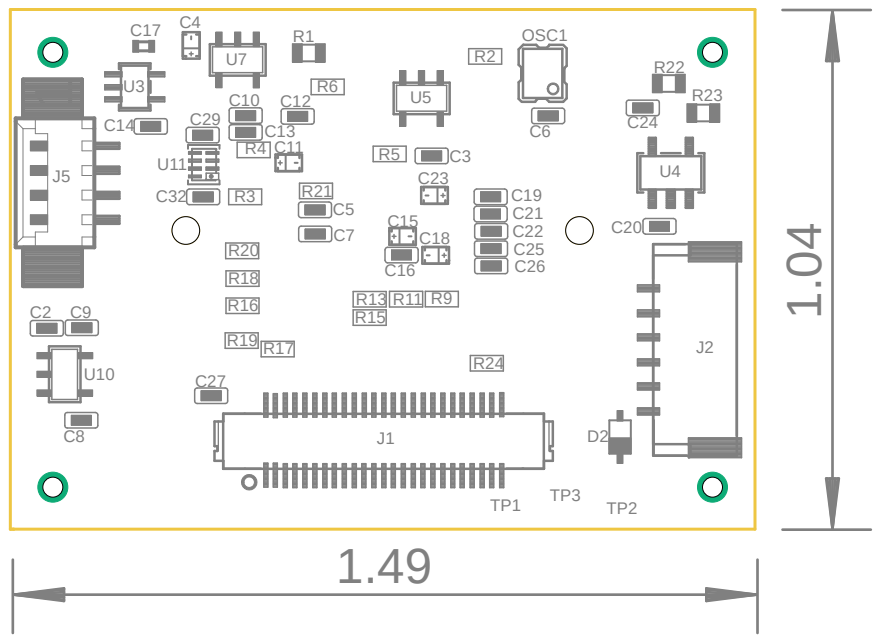
[picture p132: page 1]
