phamtaiece/Capstone-Sightline/EAGLE files/Projects/SLA_1500_CAM_V5.brd

## EAGLE design EAGLE files/Projects/SLA_1500_CAM_V5.brd (2019-04-03, an earlier design)

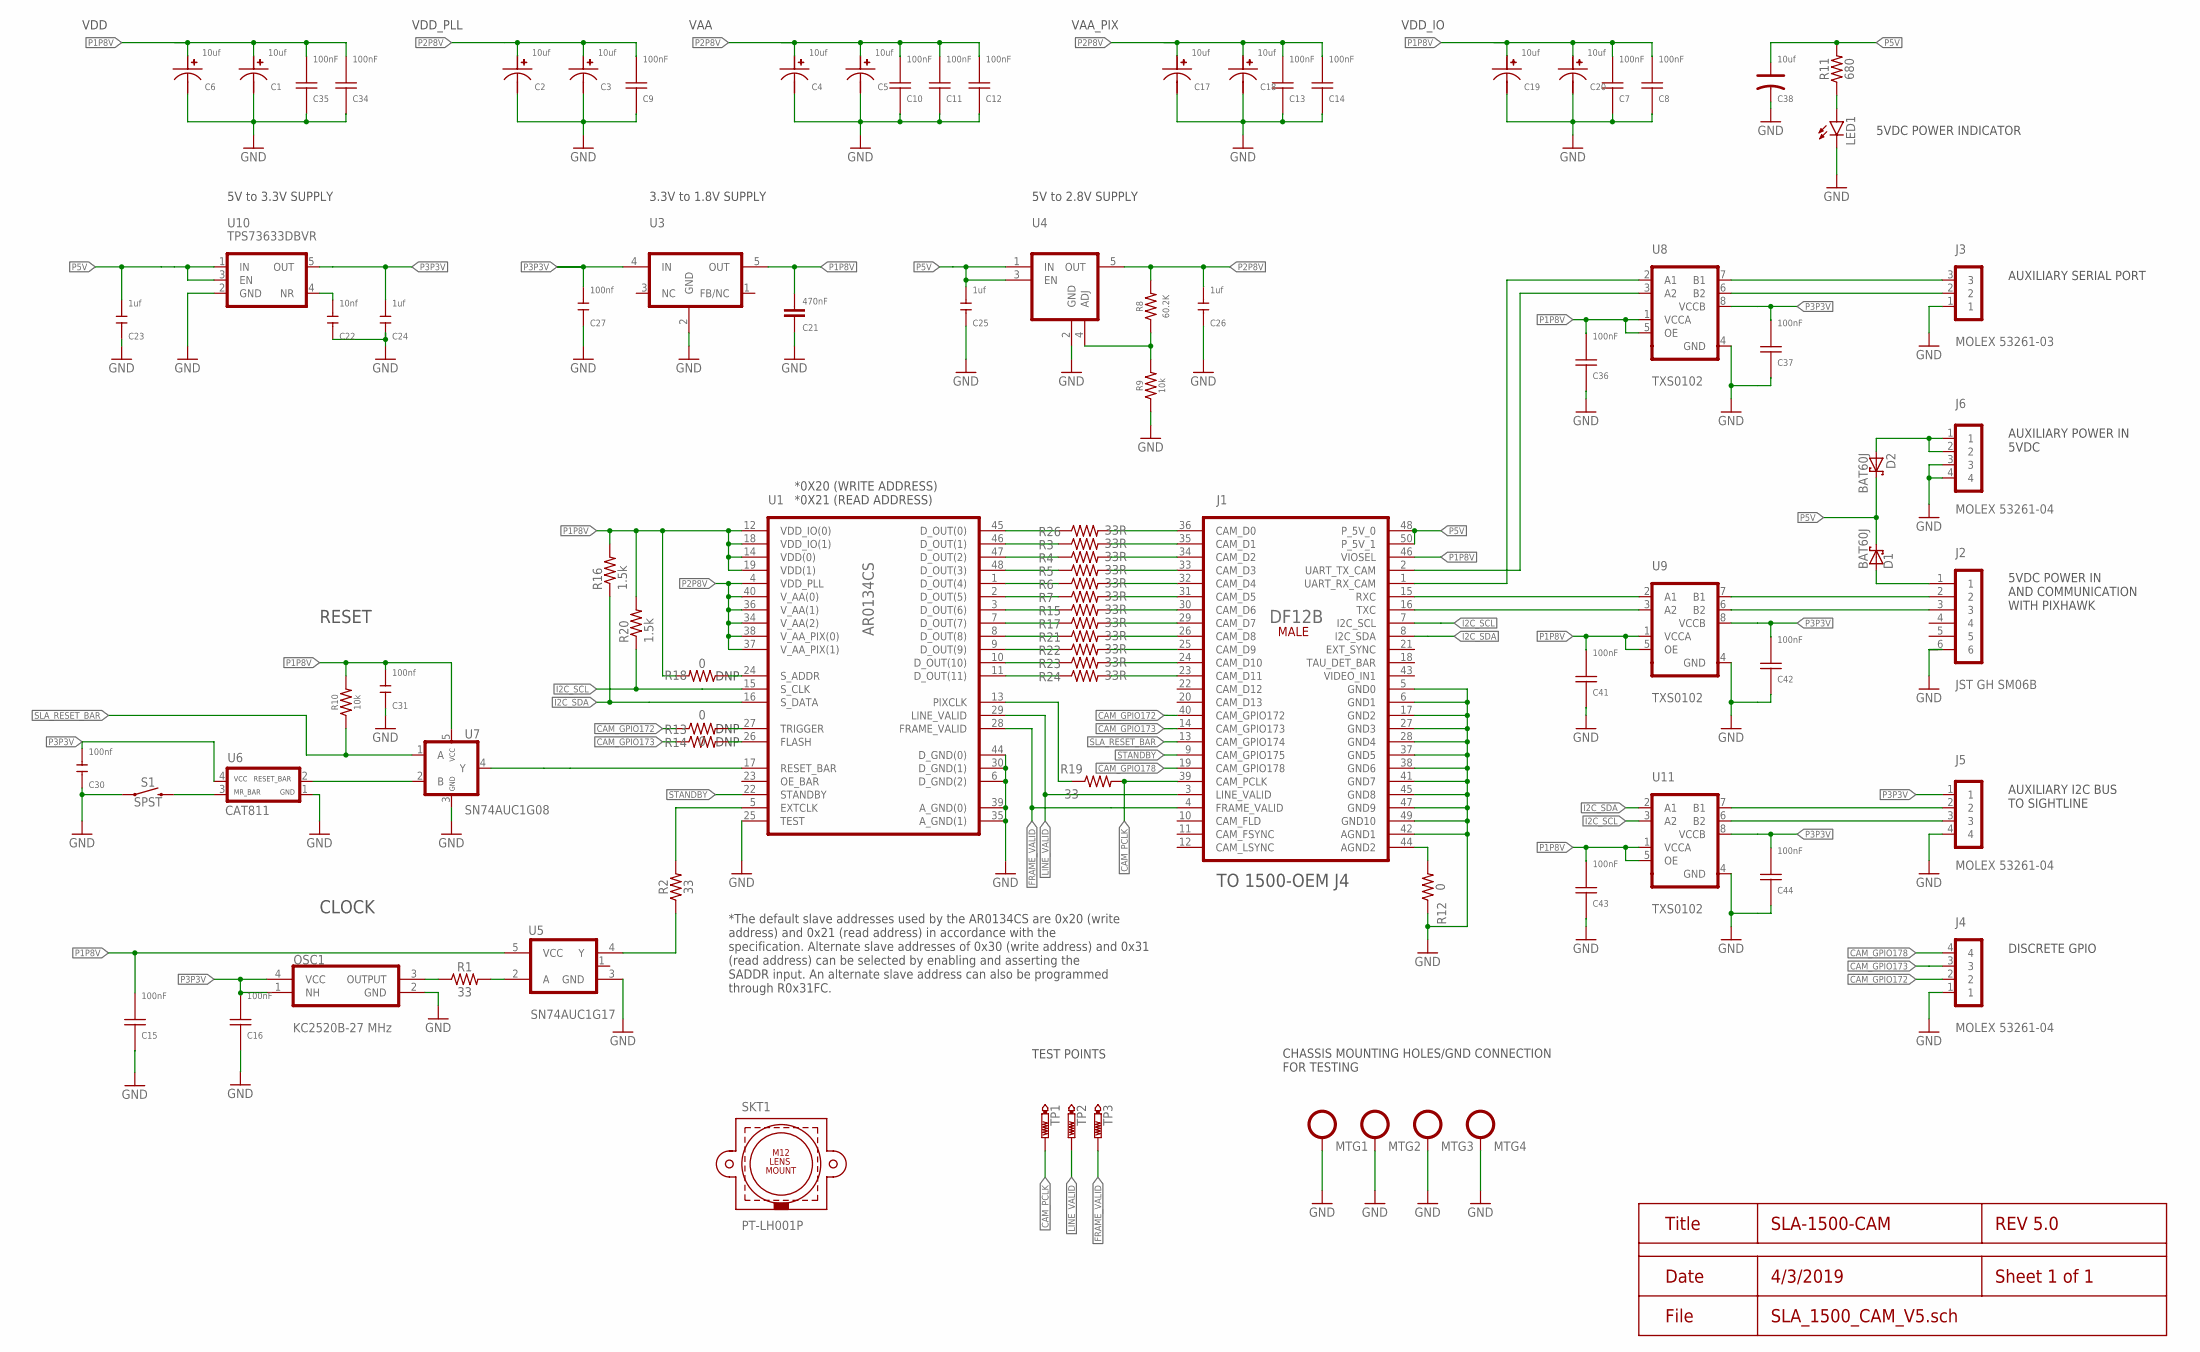
[picture p136: schematic SLA_1500_CAM_V5.sch]

Parts:
C1, C2, C3, C4, C5, C6, C17, C18, C19, C20: 10uf; 0402
C7, C8, C9, C10, C11, C12, C13, C14, C15, C16, C34, C35, C36, C37, C41, C42, C43, C44: CAP0201100NF; R0201
C21: 470nF; 0402
C22: 10nf; C0402
C23, C24, C25, C26: 1uf; C0402
C27, C30, C31: 100nf; C0402
C38: 10uf; AVX-A
D1, D2: BAT60J; SOD323_ST
J1: DF12B(5.0)-50DS-0.5(86)SMT; DF12B(5.0)-50DS-0.5V(86)
J2: JST GH SM06B; JST_SM06B-GHS-TB
J3: MOLEX 53261-03; 53261-03
J4, J5, J6: MOLEX 53261-04; 53261-04
LED1: LEDCHIP-LED0603; CHIP-LED0603
MTG1, MTG2, MTG3, MTG4: SLA_MOUNTING
OSC1: KC2520B-27MHZ; 2.5X2.0_SMDCRYSTAL
R1, R2, R19: 33; 0402
R3, R4, R5, R6, R7, R15, R17, R21, R22, R23, R24, R26: 33R; R0201
R8: 60.2K; 0603
R9, R10: 10k; 0603
R11: 680; 0603
R12, R13, R14, R18: 0; 0402
R16, R20: 1.5k; R0201
S1: SPST; TACTILE_SWITCH_SMD_4.6X2.8MM
SKT1: PT-LH001P; M12_HOLDER
TP1, TP2, TP3: PTR1TP08SQ; TP08SQ
U1: AR0134CS-ILCC48; ILCC48_KD
U3: TPS71518DCKR; TI-SC70-5
U4: AP7331-WG-7; SOT-25
U5: SN74AUC1G17; SOT23-5
U6: CAT811; SOT-143-4
U7: SN74AUC1G08; SOT23-5
U8, U9, U11: TXS0102; X2SON(8)1.8X1.2MM
U10: TPS73633DBVR; SOT23-5

Connections:
CAM_GPIO172: J1.40 (CAM_GPIO172), J4.2, R13.1
CAM_GPIO173: J1.14 (CAM_GPIO173), J4.3, R14.1
CAM_GPIO178: J1.19 (CAM_GPIO178), J4.4
CAM_PCLK: J1.39 (CAM_PCLK), R19.2, TP1.TP
FRAME_VALID: J1.4 (FRAME_VALID), TP3.TP, U1.28 (FRAME_VALID)
GND: C1.2, C2.2, C3.2, C4.2, C5.2, C6.2, C7.2, C8.2, C9.2, C10.2, C11.2, C12.2, C13.2, C14.2, C15.2, C16.2, C17.2, C18.2, C19.2, C20.2, C21.2, C22.1, C23.1, C24.1, C25.1, C26.1, C27.1, C30.1, C31.1, C34.2, C35.2, C36.2, C37.2, C38.-, C41.2, C42.2, C43.2, C44.2, J1.5 (GND0), J1.6 (GND1), J1.17 (GND2), J1.27 (GND3), J1.28 (GND4), J1.37 (GND5), J1.38 (GND6), J1.41 (GND7), J1.42 (AGND1), J1.45 (GND8), J1.47 (GND9), J1.49 (GND10), J2.6, J3.1, J4.1, J5.4, J6.3, J6.4, LED1.C, MTG1.P$1, MTG2.P$1, MTG3.P$1, MTG4.P$1, OSC1.2 (GND), R9.1, R12.1, S1.1, S1.2 (1), U1.6 (D_GND(2)), U1.25 (TEST), U1.30 (D_GND(1)), U1.35 (A_GND(1)), U1.39 (A_GND(0)), U1.44 (D_GND(0)), U3.2 (GND), U4.2 (GND), U5.3 (GND), U6.1 (GND), U7.3 (GND), U8.4 (GND), U9.4 (GND), U10.2 (GND), U11.4 (GND)
I2C_SCL: J1.7 (I2C_SCL), R20.1, U1.15 (S_CLK), U11.3 (A2)
I2C_SDA: J1.8 (I2C_SDA), R16.1, U1.16 (S_DATA), U11.2 (A1)
LINE_VALID: J1.3 (LINE_VALID), TP2.TP, U1.29 (LINE_VALID)
unnamed: J2.3, U9.6 (B2)
unnamed: R26.1, U1.45 (D_OUT(0))
unnamed: J1.36 (CAM_D0), R26.2
unnamed: R3.1, U1.46 (D_OUT(1))
unnamed: J1.35 (CAM_D1), R3.2
unnamed: R4.1, U1.47 (D_OUT(2))
unnamed: J1.34 (CAM_D2), R4.2
unnamed: R5.1, U1.48 (D_OUT(3))
unnamed: J1.33 (CAM_D3), R5.2
unnamed: R6.1, U1.1 (D_OUT(4))
unnamed: J1.32 (CAM_D4), R6.2
unnamed: R7.1, U1.2 (D_OUT(5))
unnamed: J3.3, U8.7 (B1)
unnamed: J1.31 (CAM_D5), R7.2
unnamed: R1.2, U5.2 (A)
unnamed: OSC1.3 (OUTPUT), R1.1
unnamed: J2.2, U9.7 (B1)
unnamed: J3.2, U8.6 (B2)
unnamed: J1.1 (UART_RX_CAM), U8.2 (A1)
unnamed: J1.2 (UART_TX_CAM), U8.3 (A2)
unnamed: C22.2, U10.4 (NR)
unnamed: R15.1, U1.3 (D_OUT(6))
unnamed: R8.1, R9.2, U4.4 (ADJ)
unnamed: J1.30 (CAM_D6), R15.2
unnamed: R2.1, U5.4 (Y)
unnamed: R2.2, U1.5 (EXTCLK)
unnamed: S1.3 (2), S1.4 (2), U6.3 (MR_BAR)
unnamed: U6.2 (RESET_BAR), U7.2 (B)
unnamed: U1.17 (RESET_BAR), U7.4 (Y)
unnamed: LED1.A, R11.1
unnamed: J1.44 (AGND2), R12.2
unnamed: R13.2, U1.27 (TRIGGER)
unnamed: R14.2, U1.26 (FLASH)
unnamed: D1.A, J2.1
unnamed: J1.15 (RXC), U9.2 (A1)
unnamed: J1.16 (TXC), U9.3 (A2)
unnamed: J5.2, U11.7 (B1)
unnamed: J5.3, U11.6 (B2)
unnamed: D2.A, J6.1, J6.2
unnamed: R17.1, U1.7 (D_OUT(7))
unnamed: J1.29 (CAM_D7), R17.2
unnamed: R21.1, U1.8 (D_OUT(8))
unnamed: J1.26 (CAM_D8), R21.2
unnamed: R22.1, U1.9 (D_OUT(9))
unnamed: J1.25 (CAM_D9), R22.2
unnamed: R23.1, U1.10 (D_OUT(10))
unnamed: J1.24 (CAM_D10), R23.2
unnamed: R24.1, U1.11 (D_OUT(11))
unnamed: J1.23 (CAM_D11), R24.2
unnamed: R18.1, U1.24 (S_ADDR)
P1P8V: C1.1, C6.1, C7.1, C8.1, C15.1, C19.1, C20.1, C21.1, C31.2, C34.1, C35.1, C36.1, C41.1, C43.1, J1.46 (VIOSEL), R10.2, R16.2, R18.2, R20.2, U1.12 (VDD_IO(0)), U1.14 (VDD(0)), U1.18 (VDD_IO(1)), U1.19 (VDD(1)), U3.5 (OUT), U5.5 (VCC), U7.5 (VCC), U8.1 (VCCA), U8.5 (OE), U9.1 (VCCA), U9.5 (OE), U11.1 (VCCA), U11.5 (OE)
P2P8V: C2.1, C3.1, C4.1, C5.1, C9.1, C10.1, C11.1, C12.1, C13.1, C14.1, C17.1, C18.1, C26.2, R8.2, U1.4 (VDD_PLL), U1.34 (V_AA(2)), U1.36 (V_AA(1)), U1.37 (V_AA_PIX(1)), U1.38 (V_AA_PIX(0)), U1.40 (V_AA(0)), U4.5 (OUT)
P3P3V: C16.1, C24.2, C27.2, C30.2, C37.1, C42.1, C44.1, J5.1, OSC1.1 (NH), OSC1.4 (VCC), U3.4 (IN), U6.4 (VCC), U8.8 (VCCB), U9.8 (VCCB), U10.5 (OUT), U11.8 (VCCB)
P5V: C23.2, C25.2, C38.+, D1.C, D2.C, J1.48 (P_5V_0), J1.50 (P_5V_1), R11.2, U4.1 (IN), U4.3 (EN), U10.1 (IN), U10.3 (EN)
PIXCLK: R19.1, U1.13 (PIXCLK)
SLA_RESET_BAR: J1.13 (CAM_GPIO174), R10.1, U7.1 (A)
STANDBY: J1.9 (CAM_GPIO175), U1.22 (STANDBY)

Notes on the sheet:
AUXILIARY POWER IN 5VDC
AUXILIARY I2C BUS TO SIGHTLINE
DISCRETE GPIO
5VDC POWER IN AND COMMUNICATION WITH PIXHAWK
AUXILIARY SERIAL PORT
5V to 3.3V SUPPLY
3.3V to 1.8V SUPPLY
5V to 2.8V SUPPLY
TO 1500-OEM J4
DNP
5VDC POWER INDICATOR
*The default slave addresses used by the AR0134CS are 0x20 (write address) and 0x21 (read address) in accordance with the specification. Alternate slave addresses of 0x30 (write address) and 0x31 (read address) can be selected by enabling and asserting the SADDR input. An alternate slave address ca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
*0X20 (WRITE ADDRESS) *0X21 (READ ADDRESS)
CHASSIS MOUNTING HOLES/GND CONNECTION FOR TESTING
TEST POINTS
CLOCK
RESET
VDD
VDD_PLL
VAA
VAA_PIX
VDD_IO

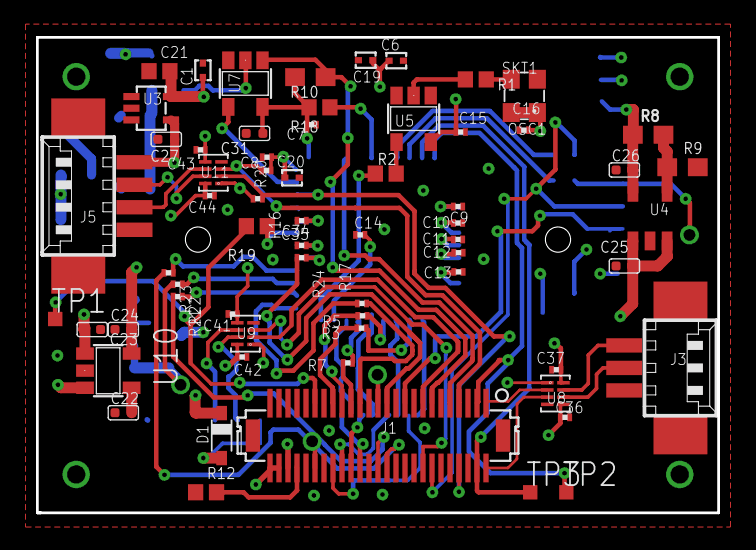
[picture p137: board SLA_1500_CAM_V5.brd from above]

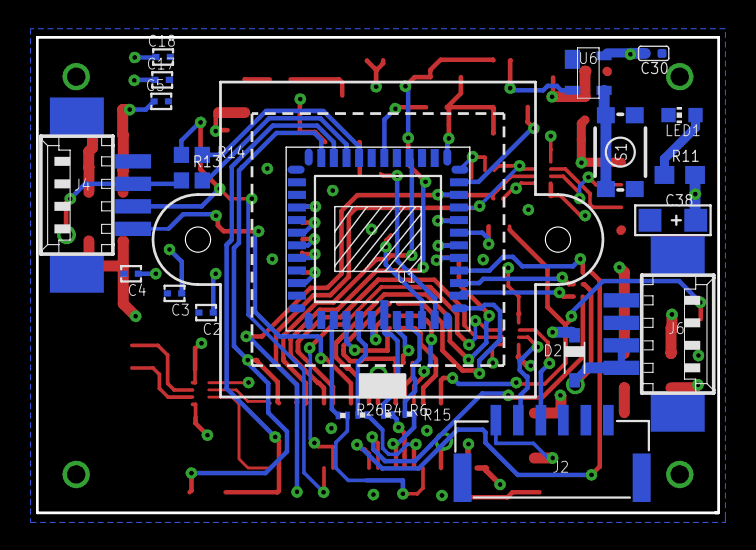
[picture p138: board SLA_1500_CAM_V5.brd from below]

Board: 4 copper layers, 37.8 x 26.4 mm, 92 parts (24 on the bottom side), 66 nets.
