phamtaiece/Capstone-Sightline/(commit log)

2018-12-13 Added Google Drive docs
    [LandingAidRange.xlsx, SLA-1500-FFC_RevC_Bill of Materials.xlsx]
2019-01-01 Added proposal 3, BOM, and datasheets
    [Capstone_Quadcopter_Bill of Materials.xlsx]
2019-01-14 Added AR0134 files
    AR0134 datasheet, BOMs from ONSemi, and BOM.xslx for capstone
    [Capstone_AR0134CS_BOM.xlsx]
2019-01-15 update Quadcopter BOM
    Included LiPo Battery charger, and addtional telemetry for ground control
    [Capstone_Quadcopter_Bill of Materials.xlsx]
2019-01-15 Update Capstone_Quadcopter_Bill of Materials.xlsx
    [Capstone_Quadcopter_Bill of Materials.xlsx]
2019-01-16 Create Group schedule.xlsx
    [Group schedule.xlsx]
2019-01-16 Create GROUND RULES.docx
2019-01-16 Update Quadcotper BOM
    Included fireproof LiPo bag
    [Capstone_Quadcopter_Bill of Materials.xlsx, SLA-1500-FFC_RevC_Bill of Materials.xlsx]
2019-01-16 NEW: SightLine Landing aid sample code
    [laArduCopter.obj, laMain.obj, laPX4.obj, laSla.obj, laVtRes.obj]
2019-01-16 DEL: too agressive with my checkin
    [laArduCopter.obj, laMain.obj, laPX4.obj, laSla.obj, laVtRes.obj]
2019-01-16 added Interesting_Reading folder and Drone Comm and Command article from Circuit Cellar magazine
2019-01-18 Update GROUND RULES.docx
2019-01-22 Add DF12B docs
    [SLA-1500-FFC_RevC_Bill of Materials.xlsx]
2019-01-23 Update SLA-1500-FFC_RevC_Bill of Materials.xlsx
    [SLA-1500-FFC_RevC_Bill of Materials.xlsx]
2019-01-27 Added Eagle Files .lbr and .sch
    [Devices.sch]
2019-01-28 SightLine setup instructions for Airborne Innovations camera (On-Semi sensor)
    Airborne Innovations makes a camera based on the On-Semi sensor chosen for this project. This camera and the reference design provided by On-Semi will be used to make a custom board. These software configuration instructions will be expected to work with this new board.
2019-02-01 Added Bottom Plate Dimensions for F450
2019-02-05 added suggested connections doc
    Added suggested connections from Jeremy. Also renamed folder "Docs" to "Sightline Docs"
    [LandingAidRange.xlsx, SLA-1500-FFC_RevC_Bill of Materials.xlsx, SightLineSuggestedConnections.xlsx]
2019-02-05 Update SightLineSuggestedConnections.xlsx
    Added part # for JST connector
    [SightLineSuggestedConnections.xlsx]
2019-02-06 Update Sightline.lbr
    Created JST GH 6 pin connector
2019-02-07 Update Sightline Project Working Space.docx
    Added instructions for charging Batteries using Tenergy TB6B balanced charger.
2019-02-13 added Eagle Schematic V1
    [AB_BOARD_V1.sch, Capstone_AR0134CS_BOM.xlsx]
2019-02-13 update AB_board_schem_V1
    [AB_BOARD_V1.sch, SLA-1500-FFC_RevC_Bill of Materials.xlsx]
2019-02-18 Create SLA_1500_CAM_V1 schem
    Renamed schematic AB_BOARD_V1 to SLA_1500_CAM_V1. Added IO
    [SLA_1500_CAM_V1.sch]
2019-02-18 Deleted AB_BOARD_V1 files
    [AB_BOARD_V1.sch, Devices.sch]
2019-02-18 Update SLA_1500_CAM schem
    Created Devices, symbols, and footprints for power management
    [SLA_1500_CAM_V1.sch]
2019-02-19 Update SLA_1500_CAM schem
    [SLA_1500_CAM_V1.sch]
2019-02-19 Added SLA_1500_CAM_BOM_V1
    Deleted AB_BOARD_BOM
    [AB_board_BOM_v1.xlsx, SLA_1500_CAM_BOM_V1.xlsx]
2019-02-25 Update Capstone_Quadcopter_Bill of Materials.xlsx
    Added replacement propellers
    [Capstone_Quadcopter_Bill of Materials.xlsx]
2019-02-26 Added case build Pics
2019-02-28 Initial Schematic review
2019-03-02 Update SLA_1500_CAM
    [SLA_1500_CAM_V2.sch]
2019-03-03 Added SLA_1500_CAM_CONN
    [SLA_1500_CAM_CONN.xlsx, SightLineSuggestedConnections.xlsx]
2019-03-04 Update SLA 1500 CAM V2
    [SLA_1500_CAM_V2.sch]
2019-03-13 Create SLA_1500_CAM REV 3
    [SLA_1500_CAM_V3.sch]
2019-03-19 Update SLA1500_CAM REV 3.0
    Replaced vertical Molex connectors with right angle Molex connectors
    [SLA_1500_CAM_V3.sch]
2019-03-20 Update Schem and Brd
    [SLA_1500_CAM_V3.sch]
2019-03-21 Create SLA1500 CAM V4 .schem and .brd
    [SLA_1500_CAM_V4.brd, SLA_1500_CAM_V4.sch]
2019-03-24 Update SLA1500 CAM V4
    [SLA_1500_CAM_V4.brd, SLA_1500_CAM_V4.sch]
2019-03-26 Update SLA1500 CAM
    [SLA_1500_CAM_V4.brd]
2019-03-27 Update SLA1500 CAM V4 .brd
    [SLA_1500_CAM_V4.brd]
2019-04-01 Create SLA1500 CAM V5 .brd .sch
    [SLA_1500_CAM_V5.brd, SLA_1500_CAM_V5.sch]
2019-04-01 Update SLA1500 CAM V5 .brd
    [SLA_1500_CAM_V5.brd]
2019-04-03 Create SLA1500 CAM BOM V2
    [SLA_1500_CAM_BOM_V5.xlsx, SLA_1500_CAM_V5.csv]
2019-04-03 Create Test Plan for new circuit board.docx
2019-04-04 Create SLA1500 CAM V6 .brd .sch
    [SLA_1500_CAM_V6.brd, SLA_1500_CAM_V6.sch]
2019-04-04 Update SLA1500 CAM V6 .brd
    [SLA_1500_CAM_V6.brd]
2019-04-04 Update SLA1500 CAM V6
    [SLA_1500_CAM_V6.brd, SLA_1500_CAM_V6.sch]
2019-04-16 Update SLA1500 CAM V6
    Repositioned C16 and C18 coupling capacitors
    [SLA_1500_CAM_V6.brd]
2019-04-21 Create Capstone BOM Feedback.xlsx
    [Capstone BOM Feedback.xlsx]
2019-04-21 Create SLA1500_CAM_BOM_V7
    [Capstone BOM Feedback.xlsx, SLA_1500_CAM_BOM_V6.xlsx, SLA_1500_CAM_BOM_V7.xlsx]
2019-04-21 Create SLA1500_CAM_V7
    [SLA_1500_CAM_V7.brd, SLA_1500_CAM_V7.sch]
2019-04-22 Update SLA1500CAM V7
    [SLA_1500_CAM_V7.brd]
2019-04-22 Update SLA1500CAM V6
    [SLA_1500_CAM_V6.brd]
2019-04-22 Create SLA1500CAM gerbers
    [SLA_1500_CAM_V7.brd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]
2019-04-22 Create Zipped Gerber Files
2019-04-22 Create SLA1500CAM_V7 zipped gerbers
    [SLA_1500_CAM_V7.brd]
2019-04-29 Create SLA1500CAM V8
    [SLA_1500_CAM_V8.brd, SLA_1500_CAM_V8.sch]
2019-04-29 Create SLA1500CAM V8.fab
    This was created just for exporting FAB docs
    [SLA_1500_CAM_V8_fab.brd, SLA_1500_CAM_V8_fab.sch]
2019-04-29 Rename SLA1500cam_fab
    [SLA_1500_CAM_fab.brd, SLA_1500_CAM_fab.sch]
2019-05-05 Create SLA1500CAM Test xlsx
    [SLA1500_CAM_Test.xlsx]
2019-06-05 Update Final Documentation
    [SLA_1500_CAM_BOM_V8.xlsx, SLA_1500_CAM_CONN_V2.xlsx, SLA_1500_CAM_CONN_V3.xlsx, SLA_1500_CAM_V8.brd, SLA_1500_CAM_V8.sch]
2019-06-07 Added Power Point
